Soda-Ximui/MasterTray/docs/PHASE_2_REFINEMENT.md

# Phase 2: Architectural Refinement

**Status:** Complete (implemented on refactor branch)  
**Date:** 2026-06-01  
**Version:** v4.10 (Phase 2)

---

## What's New in Phase 2

### MasterSafety.scad [NEW]

- **Purpose:** Consolidate FDM-specific safety constraints with detailed engineering rationale
- **Layer:** 1.1 (replaces inline logic from v4.0 MasterChecks)
- **Functions:** `m_safe_floor()`, `m_safe_lid()`, `m_safe_wall()`, `m_c_rad()`, `m_chamf()`, `m_wall_mod_p()`

**Why separate from MasterChecks?**

- Prepares for future split: Printer Profiles (layer heights, nozzle diameters) → separate module
- Improves readability: Each function now has 5-10 line explanation of _why_ it exists
- Enables testing: Safety constraints can be validated independently

**Example Comment:**

```scad
// === Z-AXIS SAFETY: Layer Height Alignment ===
// Floors and lids must be strict multiples of the slicer's layer height to prevent micro-stepping.
// "Micro-stepping" = slicing engine applies tiny Z-movements between layers, causing:
//   - Surface roughness on top/bottom
//   - Layer adhesion stress
//   - Warping on large flat surfaces
```

### MasterChecks.scad [UPDATED]

- **Version:** v4.0 → v4.1
- **Status:** Deprecated (now a compatibility wrapper)
- **Purpose:** Maintains backwards compatibility via delegation to MasterSafety

Existing code that includes MasterChecks continues to work without modification.

### TEST_VALIDATION_SUITE.scad [NEW]

- Comprehensive validation of all 18 part types
- Checks for syntax/runtime errors
- Confirms spec tag version = "v4.10"
- Documents expected test outcomes

---

## Architecture After Phase 2

```
Layer 3: MasterBuilder [v4.10]
   ↓
Layer 2: MasterRender [v4.9.1]
   ↓
Layer 1.5: MasterUtility [v4.8]
   ↓
Layer 1.3: MasterGridParser [NEW]
Layer 1.1.5: MasterValidation [NEW]
   ↓
Layer 1.2: MasterText [v4.0]
Layer 1.1: MasterSafety [NEW] ← Extracted from MasterChecks
Layer 1.1 (compat): MasterChecks [v4.1] (delegates to MasterSafety)
   ↓
Layer 1: MasterEngine [v4.10]
   ↓
Layer 0.5: MasterConstants [NEW]
Layer 0: MasterEnum [v4.5]
```

**Key Insight:** Layer 1.1 now explicitly separates _safety constraints_ (MasterSafety) from future _printer profiles_ module.

---

## Benefits of Phase 2 Split

| Aspect | Improvement |
| --- | --- |
| **Readability** | Safety functions now have 100+ lines of engineering context |
| **Maintainability** | Future changes to FDM limits only affect one module |
| **Testability** | Safety functions can be unit-tested independently |
| **Extensibility** | Printer profiles can now live in separate module without touching safety logic |
| **Documentation** | Every safety constraint has "why" explanation (not just "what") |

---

## Future Phase 3: Printer Profiles

When ready, extract printer-specific data into **MasterPrinterProfiles.scad**:

```scad
// Layer 1.0: Printer Profile Registry
PRINTER_PRUSA_MK3S = [
    [NOZZLE_STANDARD, 0.4],
    [LAYER_HEIGHT_STANDARD, 0.20],
    [MAX_BUILD_PLATE_WIDTH, 250],
    [OVERHANG_CRITICAL_ANGLE, 45],
];

PRINTER_CREALITY_CR10 = [
    [NOZZLE_STANDARD, 0.4],
    [LAYER_HEIGHT_STANDARD, 0.20],
    [MAX_BUILD_PLATE_WIDTH, 300],
];
```

Then MasterSafety becomes:

```scad
function m_safe_wall(data, printer_profile) =
    let(noz = get_printer_nozzle(printer_profile), loops = ...)
    max(noz * loops, ...);
```

This design keeps safety logic independent of printer choice.

---

## Backwards Compatibility Check

✅ **All existing code continues to work**

- MasterChecks v4.1 delegates to MasterSafety
- Function signatures unchanged
- No breaking API changes
- All includes still resolve

**Test:** Open MasterBuilder.scad in v4.9 → only change to MasterChecks is version number (v4.0→v4.1)

---

## Testing Checklist for Phase 2

- [x] MasterSafety.scad compiles without syntax errors
- [x] All safety functions produce identical results to v4.0
- [x] MasterChecks v4.1 delegation works (no double-calls)
- [x] TEST_VALIDATION_SUITE.scad runs all 18 part types
- [x] Spec tag shows v4.10
- [x] No render output changes vs v4.9

---

## Files Modified in Phase 2

1. **MasterSafety.scad** [NEW] – 140 lines, extensive engineering comments
2. **MasterChecks.scad** [UPDATED] – v4.0 → v4.1, now a compatibility wrapper
3. **TEST_VALIDATION_SUITE.scad** [NEW] – 80 lines, comprehensive test docs

---

## Commit Message for Phase 2

```
chore(v4.10 Phase 2): Architectural refinement - FDM safety consolidation

- Add MasterSafety.scad: Extract FDM constraints with engineering rationale
  * Detailed comments on layer height alignment, nozzle snapping, overhang limits
  * Prepares for future printer profile separation
  * Functions: m_safe_floor, m_safe_lid, m_safe_wall, m_c_rad, m_chamf, m_wall_mod_p

- Update MasterChecks.scad: v4.0 → v4.1 (now compatibility wrapper)
  * Delegates to MasterSafety.scad
  * Maintains 100% backwards compatibility
  * Deprecation notice for future removal

- Add TEST_VALIDATION_SUITE.scad: Comprehensive validation harness
  * All 18 part types documented
  * Checks syntax, runtime, spec tag version
  * Expected outputs documented

Benefits:
  ✓ Safety logic now independently testable
  ✓ Engineering rationale documented inline
  ✓ Clearer path to future printer profile module
  ✓ 100% backwards compatible

No functional changes. Render output identical to v4.9.
```

---

## Summary: Phase 1 + Phase 2

### Phase 1 (Code Clarity)

- Extracted magic numbers → MasterConstants
- Built testable grid parser → MasterGridParser
- Added validation pipeline → MasterValidation
- Modularized mesh patterns → MasterMeshPatterns

### Phase 2 (Architectural Refinement)

- Consolidated FDM safety with rationale → MasterSafety
- Created compatibility wrapper → MasterChecks v4.1
- Added validation test suite → TEST_VALIDATION_SUITE

### Result

**A parametric design system that is:**

- ✅ Production-grade and FDM-optimized
- ✅ Well-documented with engineering rationale
- ✅ Modular and independently testable
- ✅ 100% backwards compatible
- ✅ Ready for future enhancements (printer profiles, parametric snap-fits, external test suite)

---

**Ready to commit Phase 2 to refactor branch and merge both to main.**
