Soda-Ximui/MasterTray/docs/Claude Review.md

Updated todo list

Read [](file:///c%3A/repos/3D/MasterTray/MasterUtility.scad#1-101), lines 1 to 100

Read [](file:///c%3A/repos/3D/MasterTray/MasterEngine.scad)

Read [](file:///c%3A/repos/3D/MasterTray/MasterEnum.scad)

Read [](file:///c%3A/repos/3D/MasterTray/MasterUtility.scad#100-301), lines 100 to 300

Read [](file:///c%3A/repos/3D/MasterTray/MasterText.scad#1-81), lines 1 to 80

Read [](file:///c%3A/repos/3D/MasterTray/MasterChecks.scad#1-81), lines 1 to 80

Read [](file:///c%3A/repos/3D/MasterTray/MasterRender.scad)

Read [](file:///c%3A/repos/3D/MasterTray/MasterBuilder.scad)

Now let me create a comprehensive summary document:

Read [](file:///c%3A/repos/3D/MasterTray/MasterUtility.scad#100-201), lines 100 to 200

Read [](file:///c%3A/repos/3D/MasterTray/MasterChecks.scad)

Perfect! Now I have reviewed all the core SCAD files. Let me provide you with a comprehensive summary:

---

## **MASTER TRAY ECOSYSTEM: COMPREHENSIVE REVIEW**

### **Architecture Overview**
Your system uses a **4-layer modular architecture** with clean separation of concerns:

```
Layer 3: MasterBuilder.scad    (UI & Controller)
   ↓
Layer 2: MasterRender.scad     (Render Pipeline & Geometry)
   ↓
Layer 1.5: MasterUtility.scad  (Utilities & Output)
   ↓
Layer 1.1: MasterChecks.scad   (Safety & Validation)
Layer 1.2: MasterText.scad     (Text Engine)
   ↓
Layer 1: MasterEngine.scad     (Math Kernel & Data Router)
   ↓
Layer 0: MasterEnum.scad       (Lexicon & Constants)
```

---

### **FEATURES SUMMARY**

**Core Capabilities:**
1. **18+ Part Types** – Boxes, trays, lids, jars, flip boxes, pegs, grids, plaques
2. **6 Mesh Patterns** – Honeycomb, Teardrop, Slotted, Circle, Square, Diamond (+ None)
3. **Advanced Grid System** – 2D Cartesian (Nx×Ny) and Radial (R rays, C center)
4. **Snap-Fit Assembly** – C-clips, manifold bridges, hinge pins (4mm diameter)
5. **Threading System** – Built-in threaded jars with adjustable pitch
6. **Stackable Tray Variants** – Nesting, peg-based modular system
7. **Wall Modifications** – Selectable per-wall height (None/50%/25%/Dropped)
8. **Tolerance Handling** – Snap gaps (0.1mm), clip clearances, auto-tuned dimensions
9. **Metadata System** – Spec tags with version, printer settings, nozzle diameter
10. **Text/Plaque Engine** – Dynamic sizing, embossed/debossed text, copyright stamping

**Customization Depth:**
- 35+ UI parameters exposed in Customizer
- Printer settings (layer height, wall loops, nozzle diameter)
- Material simulation (floor/wall/lid thickness, divider size)
- Manufacturing tolerance adjustments

---

### **IMPLEMENTATION QUALITY**

**Strengths:**

✅ **Safety-First Design Philosophy**
- Z-axis thickness locked to layer height multiples (prevents micro-stepping)
- X/Y dimensions snapped to nozzle diameter multiples
- Wall/floor heights capped at 35% of total height (prevents brick-like solids)
- All dimensions enforce minimum physical constraints

✅ **Data-Driven Architecture**
- Unified data array format: `[[KEY, value], [KEY, value], ...]`
- Single `get_val()` function for all lookups with fallback defaults
- `process_part()` pipeline enforces safety before rendering

✅ **Intelligent Mesh Generation**
- Hole spacing auto-calculated from nozzle diameter
- Strut percentage controls gap/solid ratio independently
- Margin-aware mesh for lids (account for structural needs)
- Both rectangular and cylindrical mesh support

✅ **Advanced Geometry**
- Proper C-clip orientation (gap facing UP, eliminates overhangs)
- Manifold bridges ensure watertight assemblies
- Automatic platter layout (bin packing with row wrapping)
- 3D text rendering with kerning approximation

✅ **Version Tracking & Documentation**
- Each file has semantic version numbers
- Inline comments explain R&D decisions (v4.10, v4.11 patches)
- Spec tag injection records build parameters

**Moderate Concerns:**

⚠️ **Code Density**
- Some functions are very long single-liners (line 19, 26 in MasterRender)
- Complex ternary nesting reduces readability
- No intermediate variable names in some calculations

⚠️ **String Parsing Complexity**
- Grid layout uses custom space-separated token parsing (`"7x2"`, `"R3 C10"`)
- No formal grammar—relies on string position assumptions
- Would benefit from dedicated parser module

⚠️ **Redundant Geometry Exports**
- `render_box_grid()` and `render_internal_grid()` have overlapping logic
- Could be unified with a mode parameter

⚠️ **Limited Error Handling**
- No validation for invalid grid layouts (e.g., malformed `"7x2x2"`)
- Silent fallbacks to defaults rather than warnings

⚠️ **Hard-Coded Magic Numbers**
- Hinge diameter: `4.0` (line 115, 130, 154)
- Lip height: `8.0` (line 36, 77, 154)
- Thread chamfer: `0.5` (scattered throughout)
- Spec tag size: `120x60mm` (line 20, MasterUtility)

---

### **RECOMMENDATIONS**

#### **Priority 1: Code Clarity (High Impact)**

1. **Break apart monster functions in MasterRender**
   ```scad
   // Example: Extract framed_mesh hole generation
   module apply_pattern(pat, hole, step, nx, ny) { ... }
   module render_mesh_holes(pat, hole, step, nx, ny) { ... }
   ```

2. **Add a proper Grid Layout Parser**
   ```scad
   function parse_grid_layout(g_str) = let(tokens = str_split(g_str, " "))
       [for (tok = tokens) 
        if (search("x", tok) > 0) parse_cartesian(tok)
        else if (tok[0] == "R") parse_rays(tok)
        else if (tok[0] == "C") parse_center(tok)
       ];
   ```

3. **Extract magic numbers to constants**
   ```scad
   HINGE_DIAMETER = 4.0;
   JAR_LIP_HEIGHT = 8.0;
   SPEC_TAG_WIDTH = 120;
   SPEC_TAG_HEIGHT = 60;
   ```

#### **Priority 2: Safety & Validation (Medium Impact)**

4. **Add input validation layer**
   ```scad
   function validate_part(data) = 
       let(w = get_val(WIDTH, data), 
           h = get_val(HEIGHT, data))
       (w < 10 || h < 5) ? echo("WARN: Dimensions below minimum!") : data;
   ```

5. **Generate warnings for edge cases**
   - Wall thickness > 45% of smallest dimension
   - Grid cell size < 5mm (poor printability)
   - Text string longer than plaque can hold

#### **Priority 3: Maintainability (Medium Impact)**

6. **Document the data format**
   ```scad
   // Create a reference section in MasterEngine:
   // === DATA FORMAT SPECIFICATION ===
   // All part data: [[KEY1, val1], [KEY2, val2], ...]
   // Mandatory: [TYPE, "TYPE_NAME"]
   // Optional: Anything not found falls back to Layer 0 default
   ```

7. **Add a "Constants Audit" changelog**
   Track why each magic number exists (FDM overhang limits, snap-fit tolerances, etc.)

8. **Split MasterChecks into two files**
   - `MasterSafety.scad` (thickness capping, overhang limits)
   - `MasterPrinterProfiles.scad` (layer height, nozzle mappings)

#### **Priority 4: Feature Enhancements (Lower Priority)**

9. **Consider a "Draft Mode" for faster preview**
   ```scad
   mesh_quality = "Preview"; // ["Preview", "Final"]
   // Reduces $fn, disables fine geometry
   ```

10. **Add snap-fit geometry library**
    - C-clip can be parameterized (depth, jaw spread)
    - Reusable hinge clips for other projects

11. **Export a "Bill of Materials" function**
    ```scad
    function calc_plastic_volume(data) = ...;
    function calc_support_area(data) = ...;
    // Log during build for user reference
    ```

---

### **Code Quality Score: 7.5/10**

| Dimension | Score | Notes |
|---|---|---|
| **Architecture** | 9/10 | Excellent layering, clean dependencies |
| **Safety** | 9/10 | Comprehensive tolerance enforcement |
| **Readability** | 6/10 | Dense functions, magic numbers scattered |
| **Maintainability** | 7/10 | Good versioning, but document parsing is fragile |
| **Extensibility** | 8/10 | Easy to add new part types; geometry patterns reusable |
| **Testing** | 5/10 | No test cases; validation is implicit |

---

### **Bottom Line**

This is a **production-grade parametric design system** with excellent safety guardrails and impressive feature breadth. The 4-layer architecture keeps concerns separated, and the forced FDM compliance is sophisticated.

**Immediate action items:** Extract magic numbers, document the grid parser, and break apart the dense functions. The system will become significantly easier to maintain and extend.

Would you like me to implement any of these recommendations?
