Soda-Ximui/MasterTray/docs/START.md

# MasterTray — Where to Look

| Question | Go to |
|---|---|
| What changed and why (code quality)? | `REFACTORING.md` → commit hash |
| Something is printing wrong, is it a known bug? | `BUGS.md` |
| How does feature X work by design? | `docs/FEATURES.md` |
| What rule governs this geometry decision? | `docs/LESSONS.md` |
| What's left to do? | `TODO.md` |
| Where was I? | `HANDOFF.md` |
| What tools do I need installed? | `SETUP.md` |
