Soda-Ximui/MasterTray/MasterConstants.scad

// ==============================================================================
// FILE: MasterConstants.scad
// ARCHITECTURE: Layer 0.5 (Physical & Engineering Constants)
// PURPOSE: Centralize all magic numbers with documented rationale
// ==============================================================================

// === FDM GEOMETRY CONSTRAINTS ===
// Physical limits imposed by FDM printing mechanics and materials
HINGE_DIAMETER = 4.0; // Standard snap-fit pin diameter (PETG testbed)
HINGE_DIAMETER_FLIP = 5.5; // Flip box hinge (v4.11): Increased for better rigidity
JAR_LIP_HEIGHT = 8.0; // Threaded jar neck height (supports M8-equivalent threads)
THREAD_CHAMFER = 0.5; // Chamfer on threading to prevent slicer bridging failures
SPEC_TAG_WIDTH = 120; // Spec label plate width (accommodates 6 lines of text)
SPEC_TAG_HEIGHT = 60; // Spec label plate height (splits into 3 sections)
SPEC_TAG_DEPTH = 0.6; // Thin label thickness (mounted on printed base)

// === SNAP-FIT & ASSEMBLY ===
// Tolerances and geometry for mechanical assembly (snap, clips, hinges)
HINGE_CLEARANCE = 0.2; // Clearance around hinge pin (accounts for print tolerance ±0.1mm)
HINGE_CLEARANCE_FLIP = 0.3; // Flip box hinge clearance (v4.11): Tighter for better snap-fit
CLIP_JAW_SPREAD = 0.8; // C-clip jaw opening as % of hinge diameter (80% of axle)
CLIP_JAW_SPREAD_FLIP = 0.85; // Flip box C-clip jaw spread (v4.11): Improved gripping
CLIP_WALL_THICKNESS_MULT = 4.0; // Clip wall = nozzle_diameter × this factor
HINGE_CHAMFER_FLIP = 0.8; // Flip box hinge chamfer (v4.11): Better print quality

// === MATERIAL SAFETY ===
// Percentage caps to prevent over-thick features that waste material
MAX_FLOOR_THICKNESS_PCT = 35; // Floors capped at 35% of total height (prevent solid bases)
MAX_LID_THICKNESS_PCT = 35; // Lids capped at 35% of total height
MAX_WALL_THICKNESS_PCT = 45; // Walls capped at 45% of XY footprint (prevent thick shells)

// === MINIMUM STRUCTURAL THICKNESS ===
// [GEOM-FIX: under-thin floor/lid] m_safe_floor/m_safe_lid previously floored at ONE layer
// (m_lh) — a 1-layer floor/lid won't hold a container's contents. If the user-specified
// thickness is below these structural minimums, m_safe_* bumps it up (the slicer then fills
// the extra with perimeters/infill). Bump only RAISES sub-minimum values, so the 2.0/2.4mm
// defaults are unaffected. Minimums are clamped to the MAX_*_PCT caps so a very short/small
// part can't be over-bumped. Tunable — conservative sound minimums for typical containers.
MIN_FLOOR_MM      = 1.0;  // floor never thinner than 1.0mm ...
MIN_FLOOR_LAYERS  = 3;    // ... or 3 layers, whichever is greater
MIN_LID_MM        = 1.0;  // lid never thinner than 1.0mm ...
MIN_LID_LAYERS    = 3;    // ... or 3 layers
MIN_WALL_LOOPS    = 2;    // wall never thinner than 2 perimeters (2 × nozzle)

// === FLIP BOX STRUCTURAL IMPROVEMENTS (v4.11) ===
// Reinforcement constants for flip lid geometry fixes
// Problem: Original flip box lid warps, sags, and has snap-fit failures
// Solution: Increased hinge diameter + strategic material reinforcement
LID_HINGE_REINFORCEMENT = 2.0; // Extra thickness under hinge zone (mm)
HINGE_BOSS_DEPTH = 2.0; // Hinge boss engagement depth (mm)
HINGE_BOSS_WIDTH = 1.2; // Hinge boss width for lateral support (mm)
MANIFOLD_BRIDGE_EXTRA = 1.5; // Additional manifold bridge thickness (mm)

// === OVERHANG & BRIDGING ===
// FDM print angle and overhang limits (assumes 45° critical angle)
MAX_CHAMFER_MULT = 2.5; // Chamfer capped at nozzle_diameter × 2.5 (FDM overhang limit)

// === MESH & GRID ===
// Parameters controlling pattern generation and spacing
MIN_HOLE_SPACING = 1.2;      // Minimum gap between adjacent holes (prevents wall collapse)
HEXAGON_HEIGHT_MULT = 0.866; // sin(60°) for honeycomb grid spacing
// Minimum strut width as a fraction of hole diameter (for large holes).
// 0.25 = empirical: struts stay structurally proportional as holes grow.
// Floor = nozzle_d * 2 (2 extrusion passes minimum); this ratio only wins
// when hole > nozzle_d * 8 (e.g. > 3.2mm at 0.4mm nozzle).
STRUT_HOLE_RATIO = 0.25;

// Corner rounding for square/slotted mesh holes, as a fraction of hole size.
// 0.20 = empirical compromise: shape still reads as square, corners smooth enough
// to reduce print-head deceleration at direction changes (partial jerk relief).
// Physical floor = line_width (one extrusion width — Arachne minimum).
// Ceiling = 0.5 (fully circular — shape identity lost).
// No FDM formula derives this without knowing printer acceleration and outer-wall
// speed — treat as a tuning knob. Exposed as Corner_Round_Ratio in MasterBuilder.
RECT_HOLE_ROUND_RATIO = 0.20;

// Bambu Studio default extrusion width: 105% of nozzle diameter.
// This is the minimum printable feature width — any feature narrower triggers
// Arachne to taper the bead to near-zero, causing a pressure-control slowdown.
// Exposed as line_width global in MasterEngine.
EXTRUSION_WIDTH_MULT = 1.05;

// === PLAQUE & TEXT ===
// Text rendering and sizing for embossed features
TEXT_KERNING_MULT = 0.65; // Approximate character width as size × 0.65 (Arial Black baseline)
TEXT_PLAQUE_MIN_WIDTH = 25; // Minimum plaque backing width (prevents tiny labels)
TEXT_EMBOSS_DEPTH = 1.0; // Standard depth for embossed/debossed text

// === GRID SYSTEMS ===
// Built-in vs drop-in grid dimensions
GRID_DROP_IN_TOLERANCE = 0.4; // Clearance between grid and container (allows insertion)
GRID_BASE_HEIGHT_MULT = 4.0; // Base thickness = layer_height × 4 (2-3 shells)

// === PLATTER LAYOUT ===
// Build plate packing algorithm
PLATTER_DEFAULT_GAP = 15; // Default spacing between parts on print bed
MAX_BUILD_PLATE_WIDTH = 250; // Maximum X dimension before row wrap (Prusa MK3S+)

// === BUILD SYSTEM ===
// Metadata and version tracking
BUILDER_DEFAULT_VERSION = "v4.9.1"; // Spec tag version injection

// === PRINTER PROFILE MAPPINGS ===
// Common layer height presets (used to determine safe thickness multiples)
LAYER_HEIGHT_FAST = 0.24; // Fast & Good Enough
LAYER_HEIGHT_STANDARD = 0.20; // Standard (default)
LAYER_HEIGHT_DETAILED = 0.12; // Detailed
LAYER_HEIGHT_FINE = 0.08; // Ultra Fine

// === NOZZLE PROFILES ===
// Common nozzle diameters (drives wall/floor multiplier calculations)
NOZZLE_FINE = 0.2; // Fine detail work
NOZZLE_STANDARD = 0.4; // Standard (default)
NOZZLE_MEDIUM = 0.6; // Faster prints
NOZZLE_COARSE = 0.8; // Draft work

// === AUDIT LOG ===
// When/why constants were added or changed
// v1.0: Centralized constants previously scattered across render and safety modules
//       Rationale: Enable single-point tuning for material science experiments
//       Example: Testing different snap-fit tolerances? Just adjust HINGE_CLEARANCE
