Soda-Ximui/MasterTray/RenderLid.scad

// ==============================================================================
// FILE: RenderLid.scad
// ARCHITECTURE: Layer 3 (Factory)
// PURPOSE: All lid types — Snap, Glide (H/V, Ball/Tab), Flip_Single, Screw.
//
// All lids printed face-down (flat visible surface on bed) for best finish.
//
// LID_TYPE dispatch:
//   "Snap"        — over-cap: flat panel + short skirt slides over box exterior.
//                   Friction retention; thumb notch on box −Y wall for removal.
//   "Slide"       — matchbox: flat panel rides in open-top ±X wall grooves, slides
//                   from −Y front. Two finger holes for grip. No bridging.
//   "Glide"       — slides into grooves. GLIDE_DIR: "H" (Y-axis) | "V" (X-axis).
//                   GLIDE_SNAP: "Ball" (default, two side dimples) | "Tab" (front snap).
//   "Flip_Single" — C-clip hinge on +Y face, diamond latch on −Y face.
//   "Screw"       — internally threaded cap for jars (face-down: flat top on bed).
//   default/Slip  — plain press-fit slab, no retention.
// ==============================================================================
// BOSL2/std comes via MasterEngine — do NOT re-include (OpenSCAD has no include dedup; re-parse cost ~21s) [perf]
// MasterEngine is included once by MasterBuilder.scad (single owner) — not re-included here [perf]
include <MasterTolerance.scad>
include <RenderMesh.scad>

module factory_render_lid(data, opts, phys) {
    w  = m_bw(data); l = m_bl(data); sl = m_safe_lid(data);
    sw = phys[0][1]; noz = phys[3][1];
    lid_type  = get_val("LID_TYPE",  opts, "Slip");
    glide_dir = get_val(GLIDE_DIR,   data, "H");
    glide_snap = get_val(GLIDE_SNAP, data, "Ball");
    filament  = get_val("FILAMENT_TYPE", data, "PETG");

    echo(str("-> Factory [LID] | type=", lid_type, " glide_dir=", glide_dir, " snap=", glide_snap));

    // Ball catch shared dims (Snap + Glide Ball modes).
    // Scales with box footprint so large lids get proportionally stronger retention.
    // Capped at sw*2 so the ball never exceeds the groove wall depth.
    ball_d    = glide_ball_d(w, l, sw, noz);
    ball_r    = ball_d / 2;
    ball_protr = glide_ball_protr(ball_r, breathing_room(COMP_GLIDE, data), noz);

    if (lid_type == "Snap") {
        // Over-cap lid: flat panel + short skirt slides over box exterior.
        // No beads or ridges — completely clean flat top face.
        // Printed face-down: panel on bed (smooth), skirt walls rise upward.
        // Skirt inner cavity fits over box exterior with COMP_GLIDE clearance.
        clearance   = breathing_room(COMP_GLIDE, data);
        skirt_h     = max(noz * 8, 4.0);
        chamf       = m_chamf(data);
        lid_inner_w = w + clearance;
        lid_inner_l = l + clearance;
        lid_ow      = lid_inner_w + sw * 2;
        lid_ol      = lid_inner_l + sw * 2;
        difference() {
            union() {
                apply_master_bounds(lid_ow, lid_ol, sl, m_c_rad(data), chamf)
                    up(sl / 2) framed_mesh(data, lid_ow, lid_ol, sl, false,
                                           get_mesh_cfg(data, HOLE_LID, STRUT_LID));
                // Skirt walls fused below panel; chamfer on open mouth guides lid onto box.
                translate([0, 0, sl - EPS])
                    cuboid([lid_ow, lid_ol, skirt_h + EPS], chamfer=chamf,
                           edges=TOP, anchor=BOTTOM);
            }
            // Hollow out skirt interior (slides over box exterior).
            // EPS overlap into panel avoids coplanar bottom face.
            translate([0, 0, sl - EPS])
                cuboid([lid_inner_w, lid_inner_l, skirt_h + EPS * 2], anchor=BOTTOM);
        }

    } else if (lid_type == "Slide") {
        // Matchbox slide lid: flat panel, rails ride in open-top ±X wall grooves.
        // Printed face-down. Two finger holes for grip when pulling lid open.
        // Must match box groove formulas in RenderBox "Slide" case exactly.
        glide_tol   = breathing_room(COMP_GLIDE, data);
        rail_w      = noz * 3;
        chamf       = m_chamf(data);
        finger_d    = max(noz * 8, 6.0);
        lid_w       = w - sw * 2 + rail_w * 2 - glide_tol;
        lid_l       = l - sw - glide_tol;
        difference() {
            apply_master_bounds(lid_w, lid_l, sl, m_c_rad(data), chamf)
                up(sl / 2) framed_mesh(data, lid_w, lid_l, sl, false,
                                       get_mesh_cfg(data, HOLE_LID, STRUT_LID));
            // Two finger holes: one near front (−Y, for pulling) one near back (+Y, for pushing).
            for (sy = [-1, 1])
                translate([0, sy * lid_l / 3, -EPS])
                    cyl(d=finger_d, h=sl + EPS * 2, $fn=24, anchor=BOTTOM);
        }

    } else if (lid_type == "Glide") {
        glide_tol  = breathing_room(COMP_GLIDE, data);
        lid_style  = get_val(LID_STYLE, data, "External");

        // Lid must be at least as thick as the ball diameter so the ball is fully
        // embedded — no floating shell, no rib patch needed.
        sl_glide = max(sl, ball_d);

        // Rabbet: lid steps into inner-wall groove — slightly narrower than External.
        // External: lid rides in outer-wall groove — slightly wider than interior.
        // Must match box groove formulas in RenderBox exactly.
        rabbet_d = sw / 2;
        lid_w = (lid_style == "Rabbet")
            ? ((glide_dir == "H") ? w - sw - glide_tol      : l - sw / 2)
            : ((glide_dir == "H") ? (w - sw + 0.6) - glide_tol : l - sw / 2);
        lid_l = (lid_style == "Rabbet")
            ? ((glide_dir == "H") ? l - sw / 2      : w - sw - glide_tol)
            : ((glide_dir == "H") ? l - sw / 2      : (w - sw + 0.6) - glide_tol);

        // Rabbet: sw*3 inset keeps ball clear of the corner where backing is absent.
        // External: original 2.5-radius inset (near end, short groove).
        ball_y = (lid_style == "Rabbet") ? lid_l / 2 - sw * 3 : lid_l / 2 - ball_r * 2.5;

        union() {
            apply_master_bounds(lid_w, lid_l, sl_glide, m_c_rad(data), m_chamf(data))
                up(sl_glide / 2) framed_mesh(data, lid_w, lid_l, sl_glide, false,
                                        get_mesh_cfg(data, HOLE_LID, STRUT_LID));

            if (glide_snap == "Ball") {
                for (sx = [-1, 1])
                    // noz inset matches box socket offset — both shift inward by noz so ball
                    // and socket stay aligned. Ball still fully within lid body (ball_r ≤ sl_glide/2).
                    translate([sx * (lid_w/2 + ball_r - ball_protr - noz), ball_y, sl_glide/2])
                        sphere(d=ball_d, $fn=24);
            } else {
                tab_h = sl_glide * 0.6;
                tab_d = noz * 3;
                translate([0, -lid_l/2, tab_h/2])
                    cuboid([lid_w * 0.4, tab_d, tab_h], chamfer=tab_d/2,
                           edges=FRONT, anchor=CENTER);
            }
            // Pull tab on −Y face (trailing end when inserted): grip point to slide lid out.
            // Height spans full lid thickness; depth = noz*4 past lid face.
            // Offset to +X side (away from ball catch on ±X, away from tab catch on −Y centre)
            // so the tab is easy to identify and doesn't visually conflict with the catch.
            pull_tab_d = noz * 4;
            pull_tab_h = sl_glide * 0.7;
            pull_tab_w = 10.0;
            // Clamp so tab never runs off lid edge: half-tab + noz clearance must fit within lid_w/2.
            pull_tab_x = min(lid_w * 0.35, lid_w / 2 - pull_tab_w / 2 - noz);
            // Sunk EPS below Z=0 so bottom face doesn't share the lid face plane (non-manifold).
            // +EPS toward lid body so the +Y face overlaps lid body by EPS — breaks Y coplanarity.
            translate([pull_tab_x, -lid_l/2 - pull_tab_d/2 + EPS, -EPS])
                cuboid([pull_tab_w, pull_tab_d, pull_tab_h + EPS],
                       chamfer=pull_tab_d/2, edges=[FRONT+LEFT, FRONT+RIGHT, BOTTOM+FRONT],
                       anchor=BOTTOM);
        }

    } else if (lid_type == "Flip_Single") {
        hinge_d    = 4.0;
        clearance  = breathing_room(COMP_CCLIP, data);
        flat_belly = engagement_depth(COMP_BELLY, data);
        clasp_depth = engagement_depth(COMP_CLASP, data);
        clip_wall  = noz * 4;
        clip_outer_d = hinge_d + clearance*2 + clip_wall*2;
        // C-opening gap: PLA is brittle — wider gap means less arm flex required.
        // PETG: 80% of axle d = 0.4mm flex per arm (validated). PLA: 90% = 0.2mm flex.
        clip_gap = (filament == "PLA") ? hinge_d * 0.90 : hinge_d * 0.80;
        cc_z       = clip_outer_d / 2;
        hinge_y_off = clip_outer_d / 2;
        // lid_l: body only — C-clip adds clip_outer_d on the +Y side, so the total
        // assembly is exactly l (user's specified dimension, not l + clip_outer_d).
        lid_w = w; lid_l = l - clip_outer_d; clip_len = flip_hinge_len(lid_w, sw); clip_z = sl + cc_z;
        union() {
            // Flip lid body: minimum noz chamfer on all edges regardless of global chamfer_size=0.
            apply_master_bounds(lid_w, lid_l, sl, m_c_rad(data), max(noz, m_chamf(data)))
                up(sl / 2) framed_mesh(data, lid_w, lid_l, sl, false,
                                        get_mesh_cfg(data, HOLE_LID, STRUT_LID));
            // C-clip hinge on +Y face — suppressed if lid is too narrow for mechanism
            if (clip_len > 0) {
                // +EPS on Y: cylinder is tangent to lid body +Y face at lid_l/2.
                // Tangent contact (curved surface meets flat face at a line) can produce
                // degenerate edges in CGAL. Shifting EPS moves the tangent to lid_l/2+EPS,
                // breaking the contact — cylinder no longer touches the lid body boundary.
                translate([0, lid_l/2 + hinge_y_off + EPS, clip_z])
                    difference() {
                        union() {
                            intersection() {
                                // LINE_W so cylinder ends at ±(clip_len/2+EPS), burying the
                                // connection block face (±clip_len/2) inside the cylinder solid.
                                // h=clip_len → both at ±clip_len/2 → coplanar X faces in union().
                                yrot(90) cyl(d=clip_outer_d, h=clip_len+LINE_W, chamfer=noz*3, $fn=36);
                                cuboid([clip_len+2, clip_outer_d,
                                        clip_outer_d - flat_belly*2], anchor=CENTER);
                            }
                            // B9 fix: extend this block's overlap into the lid body (toward
                            // local -Y/-Z, which is the lid's interior — the +Y/+Z side
                            // facing the back wall is untouched, so B6's clearance is
                            // unaffected). Originally only ~1mm x 1mm of this block sat
                            // inside the lid body (a tangent-line join, not a face) — a
                            // stress riser that snapped in testing.
                            // Z: anchor the block's bottom to the print bed (local Z = -clip_z,
                            // i.e. global Z = 0) instead of a fixed ext_z offset — a fixed
                            // offset can push the bottom BELOW the bed for thin lids (sl < 1mm),
                            // which showed up as a disconnected rectangular sliver + gap at
                            // layer 1. Bed-anchoring gives the maximum possible fused area
                            // (full lid thickness) for any sl, with the top reaching 2mm past
                            // clip_z into the C-clip cylinder for fusion there.
                            ext_y = 3.0;
                            translate([0, -hinge_y_off/2 - ext_y/2, -clip_z])
                                cuboid([clip_len, hinge_y_off+2.0+ext_y, clip_z+2.0],
                                       chamfer=1.0, edges=[TOP+FRONT, TOP+BACK], anchor=BOTTOM);
                        }
                        yrot(90) cyl(d=hinge_d + clearance*2, h=clip_len+2, $fn=36);
                        // C-opening faces UP (+Z): printer traces U-shapes layer-by-layer,
                        // zero overhangs. Pin snaps in as lid rotates onto the box axle.
                        // Bridge embeds +2mm total (1mm into clip, 1mm into lid body) so
                        // the slicer sees one continuous solid — no micro-gap shell split.
                        translate([0, 0, clip_outer_d/2])
                            cuboid([clip_len+2, clip_gap, clip_outer_d + LINE_W], anchor=CENTER);
                    }
            }
            // Diamond latch arm — single solid block + diamond click tip.
            // One solid arm is structurally stronger than the old two-part split arm.
            // Bottom raised to chamf+EPS: arm ±X side faces must not intersect the lid
            //   body's front-bottom chamfer face (at Y=−lid_l/2, Z=0..chamf) — that
            //   intersection produces NM edges. Chamf+EPS clears the danger zone.
            // Root gusset (hull below): tapers from zero width at Z=0 to full arm width
            //   at Z=chamf, filling the chamfer gap without touching the chamfer face.
            //   Gives the arm a solid triangle of material from lid face to arm base.
            chamf = max(noz, m_chamf(data));
            // Root gusset: triangular fill from Z=0 (zero width) to Z=chamf (full width).
            hull() {
                translate([0, -lid_l/2 - 1.1 + EPS, EPS])
                    cuboid([EPS, 2.2, EPS], anchor=BOTTOM);
                translate([0, -lid_l/2 - 1.1 + EPS, chamf + EPS])
                    cuboid([lid_w - sw*4, 2.2, EPS], anchor=BOTTOM);
            }
            // Arm body: full depth, single solid block from chamf to arm tip.
            translate([0, -lid_l/2 - 1.1 + EPS, chamf + EPS])
                cuboid([lid_w - sw*4, 2.2, sl + clasp_depth - chamf - EPS], anchor=BOTTOM);
            // Diamond tip — the click point that engages the box wall groove.
            // Protrudes 0.9mm in +Y from arm inner face — cams into box groove on close.
            // +EPS on X: hull and arm share X width (lid_w−sw*4) → coplanar ±X faces.
            // Widening hull by EPS makes arm X faces interior to hull volume (no NM edge).
            lz = layer_snap(0.8, m_lh(data));
            translate([0, -lid_l/2 - 1.5, sl + clasp_depth])
                hull() {
                    translate([0, 0,   -lz]) cuboid([lid_w-sw*4+EPS, 0.1,   noz*1.05], anchor=CENTER);
                    translate([0, 0.9,   0]) cuboid([lid_w-sw*4+EPS, noz*2, 0.1     ], anchor=CENTER);
                    translate([0, 0,    lz]) cuboid([lid_w-sw*4+EPS, 0.1,   noz*1.05], anchor=CENTER);
                }
        }

    } else if (lid_type == "Screw") {
        // cap_h: minimum thread engagement height only.
        // BEFORE: lip_h = JAR_LIP_HEIGHT; cap_h = max(0.1, lip_h + sw * 1.5);
        //   = 8.0 + 3.6 = 11.6mm — this is the JAR NECK height, not lid height.
        //   sw*1.5 taper allowance lives on the jar body; the lid doesn't need it.
        //   Total lid was sl+11.6 = 13.6mm. See BUGS.md B2.
        // cap_h driven by Lid_Thread_Count (default 3). sw*2 floor ensures
        // at least 2 full wall passes on the cap cylinder regardless of pitch.
        cap_h   = max(m_thread_pitch(data) * get_val(LID_THREAD_COUNT, data, 3), sw * 2);
        neck_od = w - sw * 2 - 0.6;
        // Face-down: flat top on bed, interior thread on vertical walls.
        // needs_margin=false: retention is in the threaded cylinder, not the flat face.
        // Snap/Glide/Flip use needs_margin=true because their mechanisms live on the border.
        difference() {
            union() {
                up(sl / 2) framed_mesh(data, w, w, sl, true,
                                        get_mesh_cfg(data, HOLE_LID, STRUT_LID));
                // EPS sink: cylinder bottom would land at Z=sl — coplanar with lid plate top.
                up(sl - EPS) cyl(d=w, h=cap_h + EPS, chamfer2=noz*4, anchor=BOTTOM);
            }
            // EPS pullback: cutter starts one boolean-epsilon below lid surface so the
            // thread is cleanly subtracted without a zero-thickness manifold edge.
            up(sl - EPS) threaded_rod(d=neck_od + 0.8, l=cap_h+1,
                                       pitch=m_thread_pitch(data),
                                       internal=false, anchor=BOTTOM, $fn=30);
        }

    } else {
        // Slip — plain press-fit slab, no retention mechanism.
        lid_w = w - sw - 0.6; lid_l = l - sw / 2 - 0.6;
        apply_master_bounds(lid_w, lid_l, sl, m_c_rad(data), m_chamf(data))
            up(sl / 2) framed_mesh(data, lid_w, lid_l, sl, false,
                                    get_mesh_cfg(data, HOLE_LID, STRUT_LID));
    }

}
