Soda-Ximui/MasterTray/(list of files, cad)

Other CAD files:
RenderRib.scad
RenderTray.scad
deprecated/MasterBuild2.scad
deprecated/TEST_VALIDATION_SUITE.scad
