Soda-Ximui/MasterTray/build/sandbox/README.md

User-created config overrides go here (gitignored).
