Soda-Ximui/MasterTray/docs/LESSONS.md

# MasterTray — Lessons Learned

---

## 0. Structural integrity and strength are non-negotiable

**Rule:** All generated containers must have decent structural integrity. These are
functional storage objects — desiccant containers, pill organizers, general storage —
not display models. They must survive real use.

**How we achieve it:**
- **Wall thickness** = snapped to nozzle multiples via `m_safe_wall` — no partial
  extrusions, no weak inter-layer gaps
- **Floor/lid thickness** = snapped to layer-height multiples via `m_safe_floor` /
  `m_safe_lid` — flat surfaces align to layer boundaries, no micro-stepping
- **Corner bosses** on stackable trays — solid cylinder pillars at all 4 corners
  distribute stacking load into the tray walls, not just the floor
- **Strut widths** = nozzle-multiple snapped (see Lesson 0c) — every mesh strut
  is a complete extrusion pass, no weak partial lines
- **Minimum wall** = `nozzle × wall_loops` — never thinner than the slicer's
  configured perimeter count
- **Mesh strut proportion** = 25% of hole diameter minimum — large holes get
  proportionally thicker struts

**Flag immediately** if any geometry change reduces wall count below `wall_loops`,
thins a load-bearing surface below `m_safe_floor`, or introduces a mesh so open
that the remaining struts can't bear typical storage loads.

---

## 0b. All edges use chamfer or fillet — no sharp 90° overhangs

**Rule:** Every edge in the system is either chamfered or filleted. No sharp 90°
horizontal edge is left exposed on a downward-facing surface.

**Why:** FDM printers cannot print a sharp 90° overhang without supports. A chamfer
≤45° is self-supporting. A fillet on a vertical edge avoids stress concentrations
and improves layer adhesion at corners.

**How we achieve it:**

| Edge type | Treatment | Mechanism |
|---|---|---|
| Vertical corners (XY plane) | Fillet | `apply_master_bounds` → `cuboid(rounding=m_c_rad)` |
| Bottom outer edge of walls | Chamfer | `m_chamf(data)` passed to BOSL2 `cuboid`/`cyl` |
| Top of cylinder (lid, boss, peg) | Chamfer2 | `cyl(..., chamfer2=m_chamf(data))` |
| Bottom of cylinder (jar floor) | Chamfer | `cyl(..., chamfer=m_chamf(data))` |
| Peg rod ends | Chamfer both ends | `cyl(..., chamfer=0.5)` |
| Snap bead | Diamond cross-section | All faces ≤45° by geometry — no explicit chamfer needed |

**Standard values** (both physics-derived from printer settings):
- `m_chamf(data)` = `nozzle × MAX_CHAMFER_MULT` — horizontal edge chamfer
- `m_c_rad(data)` = derived from wall thickness — vertical corner fillet radius

**Flag immediately** if any new geometry introduces a horizontal edge > 45° on a
downward-facing surface, or a sharp vertical corner on an outer wall.

---

## 0c. All generated models must print support-free

**Rule:** Every primitive and composite must be printable on FDM without supports.

**How we achieve it:**
- Overhangs: `m_chamf(data)` = nozzle × 2.5 caps all chamfers at 45° max
- Mesh holes: Teardrop pattern is self-bridging (pointed tip closes without drooping)
- Lids: printed **face-down** (flat visible surface on bed) so the interior cavity
  prints upward from a solid base — no bridges, no supports
- Threads: external threads (jar body) are on vertical walls ✓; internal thread
  (lid) is subtracted from a vertical cylinder wall ✓
- Grids/dividers: vertical walls, no overhangs ✓

**Flag immediately** if any new geometry introduces: overhangs > 45°, horizontal
bridges > ~60mm, or any surface that requires the model to be printed upside-down
from the orientation it ships in.

---

## 0a. Optimal print orientation — design geometry for the print bed, not the assembly

**Rule:** All primitives ship in their optimal FDM orientation. Every factory renders
geometry as it sits on the print bed — Z=0 is the bed surface, geometry builds upward.
Users adjust slicer settings (brim, speed, enclosure temp); we never change orientation
to compensate for extreme height/width ratios.

| Primitive | Optimal orientation | Reason |
|---|---|----|
| JAR | Upright (floor on bed) | Side needs supports under curved wall; diameter becomes oval |
| TRAY / BOX | Flat (floor on bed) | Layer lines horizontal through floor = maximum strength |
| LID (Screw) | Face-down (flat top on bed) | Full-circle adhesion; interior thread on vertical walls |
| LID (Snap / Glide / Slip) | Face-down (flat outer surface on bed) | Best finish on visible face; retention features build upward |
| LID (Flip_Single / Flip_Double) | Face-down | C-clip arc at top of print — self-supporting. **Opening must face −Z (toward bed).** |
| PEG | Horizontal, flat-cut underside on bed | `yrot(90)` + flat cut prevents rolling, prints without supports |
| GRID (built-in) | Part of container — inherits container orientation | |
| GRID (drop-in) | Flat (base on bed) | Divider walls print vertically; flag very long/thin — warp risk |

**Every factory's Z=0 = bed.** If you add a new factory, the lowest point of the
geometry must sit at Z=0. Use `anchor=BOTTOM` on the outermost solid or `up(sf)` for
floor-offset geometry. A factory that floats above Z=0 will print mid-air.

**Flip lid critical rule:** C-clip arc opens **downward** (slot at `−clip_outer_d/2`).
Opening at `+clip_outer_d/2` leaves arm tips unsupported at the top of the print —
floating cantilever. See B3 in BUGS.md.

**Extreme ratios:** A 49×140mm jar prints upright regardless. A 300×200×8mm tray
prints flat regardless. Extreme geometry is a slicer concern, not an orientation concern.

**Never introduce supports** to enable a non-standard orientation. If a geometry
requires supports in its natural orientation, fix the geometry.

---

## 0b. All circle dimensions are diameters, always

**Rule:** Every circular dimension in the system (jar width, hole size, peg diameter) is
an **outer diameter** — never a radius.

**Why:** Users measure physical objects with calipers. Calipers give diameter. Asking
users to divide by 2 before typing caused real frustration. The UX loss is not worth
the cleaner internal math that radius would give.

**Consequence:** `m_bw(data)` for a jar = outer diameter. All geometry uses `d=` not
`r=` when sizing the jar cylinder.

---

Hard-won lessons from building and debugging this system. Read before touching
the include graph.

---

## 0c. Mesh hole spacing snaps to nozzle-width multiples

**Rule:** `get_grid_step` produces a step (hole + strut) that is always a whole-nozzle
multiple. Never change this to a simpler formula without understanding why.

**The formula:**
```
step = hole + max(min_sp,
                  max(noz,
                      round(max(noz*2, hole*0.25) / noz) * noz))
```

**What each layer does:**

| Layer | Expression | Purpose |
|---|---|---|
| Raw strut | `max(noz*2, hole*0.25)` | Strut is at least 2 nozzle widths wide, OR 25% of the hole diameter — whichever is larger. Large holes get proportionally thicker struts. |
| Nozzle snap | `round(.../noz) * noz` | Rounds the raw strut to the nearest nozzle-width multiple. This is the critical step — the slicer always lays complete extrusion passes. A strut of 0.6mm with a 0.4mm nozzle forces a partial pass (0.2mm leftover), which can delaminate or look ugly. Snapping to 0.8mm (2 passes) is mechanically correct. |
| Floor | `max(noz, ...)` | Guards against rounding down below 1 nozzle width. |
| Override | `max(min_sp, ...)` | Caller's physics minimum (e.g. `wall_loops × nozzle`) wins if it's larger. User-set hole spacing (`HOLE_SPACING`) flows in here. |

**Why hole*0.25?** For a 4mm hole, a 0.8mm strut (2 nozzle widths) is structurally too
thin. `hole*0.25 = 1.0mm` gives a more robust strut. For small holes (≤3.2mm with a
0.4mm nozzle), `noz*2 = 0.8mm` dominates and the minimum printable strut is used.

**The result:** Every mesh tile is a printable unit. Slicer never generates micro-moves
or partial extrusions between holes. This is the difference between a mesh that looks
right in preview and one that actually prints cleanly.

**Desiccant containers** (S4 system) lock `HOLE_SPACING=1.2mm` explicitly — this
overrides `min_sp` so airflow geometry is consistent regardless of printer wall-loop
settings.

---

## 0d. Round features must fit within their host body's Z range

**Rule:** Before placing any sphere, hemisphere, or rounded protrusion at height `h/2`
within a host body of height `h`, verify: `feature_radius ≤ h/2`.

If `feature_radius > h/2`, the feature escapes the host body:
- Below Z=0 → clips the print bed (slicer truncates it)
- Above Z=h → pokes past the top face with no wall support at those layers

The top portion prints as a **floating shell** that detaches mid-print. The slicer
may not warn — it only warns if the feature has *no* connection at all. A feature
that starts connected but loses its wall attachment partway up passes slicer checks
and fails in print.

**Two confirmed failures (see BUGS.md B3, B4):**
1. C-clip hinge arm tips — arc opening at +Z left tips floating above lid top
2. Glide ball catch — sphere at sl/2 with ball_r > sl/2 → top of ball floats above lid

**Preferred fix: thicken the host body.**

If a round feature doesn't fit within the host's Z range, increase the host
thickness so it does. This is cleaner than adding ribs or repositioning geometry.

```scad
// Glide lid — ensure ball is fully embedded
sl_glide = max(sl, ball_d);   // lid at least as thick as ball diameter
// Ball center at sl_glide/2 — ball_r ≤ sl_glide/2, always within body
translate([sx * (wall_edge + ball_r - ball_protr), y, sl_glide/2])
    sphere(d=ball_d);

// Plaque socket — ensure face plate is at least as thick as socket OD
p_t_eff = max(p_t, od);       // slab fully backs the socket base, no bridging
```

**Fallback fix: full-height connecting rib.** When thickening would break mating
geometry or is too expensive dimensionally, add a rib that spans the full host
height and connects the feature to the host wall at every layer:

```scad
// Rib inset inside wall, no protrusion into groove channel
translate([sx * (wall_edge - ball_r/2), y, sl/2])
    cuboid([ball_r + EPS, ball_d * 0.7, sl + EPS], anchor=CENTER);
```

| Situation | Preferred fix | Fallback |
|---|---|---|
| Ball catch on thin slab | `sl = max(sl, ball_d)` | Full-height rib inset inside wall |
| Socket OD > slab thickness | `p_t = max(p_t, od)` | Rib / boss at socket base |
| Arc/C-shape printed face-down | Opening at −Z (arc self-supporting) | — |

**Flag immediately** any sphere, hemisphere, or cylindrical snap feature placed at the
midpoint of a thin slab without verifying the Z-range containment condition.

---

## 1. Factory IS the implementation — opts drive all variants

**Rule:** Each primitive shape has exactly ONE factory function. All behavioural
variants are driven by opts, not by separate factory functions or wrapper chains.

**Why:** Multiple render_*() wrappers around a single chassis create layered
indirection. Every new derived intent requires fighting through all layers to inject
behaviour — contorted, fragile, and hard to reason about.

**The pattern:**
```
factory_render_box(data, opts, phys) {
    lid_type = get_val("LID_TYPE", opts, "Snap");
    if      (lid_type == "Glide")        { ... groove + ball dimples inline ... }
    else if (lid_type == "Flip_Single")  { ... hinge boss + axle inline ... }
    else if (lid_type == "Flip_Double")  { ... dual hinge inline ... }
    else                                 { ... plain chassis ... }
}
```

**What this eliminates:**
- render_box() / render_flip_box() / render_double_flip_box() wrapper chain
- NEEDS_GROOVE flag smuggled through data to cross layer boundaries
- Separate factory_render_flip_box() that does nothing but call the real thing
- Adding a new variant = add one `else if` branch in ONE file

**Corollary:** The manifest is the only place that decides WHAT to build.
The factory is the only place that decides HOW to build it.
Never let behaviour bleed from manifest into data (via data overrides) just to
cross a factory boundary.

---

## 2. Built-in grid height is driven by LID_TYPE — the tray adapts to its lid

**Rule:** When a tray/box has a built-in grid (`HAS_BUILTIN_GRID=true`), the internal
divider wall height is NOT simply "tray height minus floor". It is capped by whatever
the lid type requires to close properly.

**The constraint per lid type:**

| LID_TYPE | Grid wall height cap | Reason |
|---|---|---|
| Plain / Snap / Glide | `bh - sf - sl` | Full interior height |
| `Flip_Single` | `axle_z` = `bh - clip_outer_d/2` | Lid must flip closed over dividers |
| `Flip_Double` | `axle_z` (same) | Same hinge geometry |

**How it flows:**
```
factory_render_box(data, opts, phys)
  lid_type = get_val("LID_TYPE", opts)
  grid_wall_h = lid_type == "Flip_*" ? axle_z : bh - sf - sl
  d = concat([[GRID_WALL_H, grid_wall_h]], data)  ← inject before chassis call
  core_tray_chassis(d)
    → render_internal_grid(d)
        → reads GRID_WALL_H from d
        → dividers capped at grid_wall_h
```

**The hinge pillars ARE the grid divider pillars** (on the hinge side). In
`factory_render_box` with `Flip_Single`, the inter-column divider stubs at the +Y
face serve both as structural hinge support AND as grid column separators. They
are built by `factory_render_box`, NOT by `render_internal_grid`. The internal
grid handles only the full-depth dividers running front-to-back.

**Implementation note:** `GRID_WALL_H` must be in MasterEnum and prepended to
data in the factory before calling `core_tray_chassis`. `render_internal_grid`
reads it with `get_val(GRID_WALL_H, data, bh - sf - sl)` — the fallback is the
full interior height for plain boxes.

---

## 3. `use` vs `include` for factory modules

**Rule:** Use `include` for your own factory files. Use `use` only for
third-party libraries (BOSL2).

**Why:** OpenSCAD's `use <file>` is supposed to import module and function
definitions without executing top-level code. In practice, when the used file
has nested `include` chains with complex dependencies, `use` silently fails to
register module definitions — producing "WARNING: Ignoring unknown module 'X'"
with no other explanation.

**What happened:** MasterBuilder used `use <RenderJar.scad>`. RenderJar
includes RenderMesh which includes MasterMeshPatterns and MasterEngine.
Through this chain, `factory_render_jar` was never registered in MasterBuilder's
scope. The fix was changing to `include <RenderJar.scad>`.

**Safe because:** None of the factory files (RenderJar, RenderTray, RenderLid,
etc.) contain top-level executable geometry — they are pure module definitions.
`include` on a file with no top-level execution is identical in effect to `use`,
except it reliably brings module names into scope.

**Rule of thumb:**
```
include <your_own_factory.scad>   // always safe, always works
use     <BOSL2/std.scad>          // correct for third-party libraries
```

---

## 2. `return` is not valid at the top level of an OpenSCAD file

**Rule:** Never use `return` outside a function body in OpenSCAD.

**Why:** `return` is only valid as the implicit last expression inside a
function definition. At the top level of a file, OpenSCAD may parse it as a
call to an unknown module named "return", which silently aborts processing of
the rest of the file — including all module definitions below that line.

**What happened:** RenderMesh.scad had a double-inclusion guard:
```scad
if (!is_undef(MESH_LOADED)) return;
MESH_LOADED = true;
```
When this file was included, the `return` call aborted processing of the rest
of the file. Any file that included RenderMesh.scad and defined modules *after*
that include had those modules silently dropped.

**Fix:** Remove top-level `return` guards entirely. OpenSCAD handles
double-inclusion naturally — variables and modules defined multiple times just
take the last value, and the overhead is negligible.

---

## 3. Hardcoded physics values in the manifest are wrong

**Rule:** Always compute physics from data. Never hardcode them.

**Why:** The manifest stub originally hardcoded safety values:
```scad
[["SAFE_WALL", 2.4], ["SAFE_FLOOR", 2.0]]
```
These are the defaults for a 0.4mm nozzle with specific settings. A user with
a 0.6mm nozzle, different wall loops, or a thick floor setting would silently
get wrong geometry — walls that don't match their slicer, floors that don't
align to their layer height.

**Fix:** Always call `get_physics_profile(data)` which computes safe values
from the actual user payload:
```scad
get_physics_profile(data)  // derives from nozzle, layer height, wall loops
```

---

## 4. File-level version numbers create false confidence

**Rule:** Don't version individual files — use git.

**Why:** File headers like `[v4.13]` diverge from reality the moment a file
is edited without updating the number. They also create confusion when two
files claim the same version for different states of the code.

**Fix:** Remove all `[vX.Y]` tags from file headers. `git log -- filename`
shows the real history with actual context. The header should describe
*purpose*, not version.

---

## 5. Duplicate function definitions cause silent wrong-output bugs

**Rule:** Every function lives in exactly one file.

**Why:** OpenSCAD silently uses whichever definition it sees last (determined
by include order). If two files define `get_mesh_cfg` with different signatures,
callers get unpredictable behavior depending on which file was included first —
no error, no warning, just wrong geometry.

**What happened:** `get_mesh_cfg` existed in both `MasterEngine.scad` (correct
version with `needs_margin` guard) and `MasterLegacyBridge.scad` (simplified
version with `is_lid` parameter that ignored NONE patterns). Callers passing
`true` to apply lid minimum-solid logic were silently getting wrong mesh configs.

**Fix:** Delete the duplicate. Keep the canonical version in MasterEngine.

---

## 6. `include` inside a `use`d file may not propagate module definitions upward

**Rule:** If module A is defined in file X, and file Y does `include <X>`,
then `use <Y>` from file Z may or may not make module A visible in Z's scope.

**Why:** OpenSCAD's `use` processes the direct file for definitions. Modules
from transitively `include`d files may not be promoted into the calling scope.

**Consequence:** Even if `factory_render_jar` is defined in RenderJar.scad and
RenderJar.scad is `use`d by MasterBuilder.scad, the module might not be visible.
The only reliable solution is `include`.

---

## 7. Ternary `? :` cannot select between module calls in OpenSCAD

**Rule:** Use `if/else` to choose between modules. Use `? :` only for value
expressions inside functions or variable assignments.

**Why:** In OpenSCAD, `? :` is an expression operator — it returns a value.
Module instantiations (`circle()`, `rect()`, `cyl()`) are statements, not
values. Using ternary to choose between module calls is a syntax error:

```scad
// WRONG — syntax error
linear_extrude(h) is_cyl ? circle(d=w) : rect([w, l]);

// CORRECT
linear_extrude(h) {
    if (is_cyl) circle(d=w);
    else        rect([w, l]);
}
```

**What happened:** `framed_mesh` in RenderMesh.scad used ternary to select
between `circle()` and `rect()` children of `linear_extrude`. This was masked
by the MESH_LOADED guard (lesson 2) which prevented the file from ever loading.
Removing the guard exposed the underlying syntax error.

---

## 8. Enum values must be human-readable to work with the Customizer

**Rule:** Enum constant names follow code convention (ALL_CAPS). Enum string
values must match the Customizer dropdown labels exactly (human-readable,
mixed-case).

**Why:** The OpenSCAD Customizer reads the dropdown options from inline
comments and sets the variable to that exact string:

```scad
mesh_pattern = "Teardrop"; // ["Honeycomb", "Teardrop", "Slotted"...]
//                                           ↑ this exact string becomes the value
```

So enum values must be the same human-readable strings the Customizer shows.

**The pattern that works for both worlds:**
```scad
// MasterEnum.scad — constant name is ALL_CAPS, value is human-readable
TEARDROP = "Teardrop";
HONEYCOMB = "Honeycomb";

// MasterBuilder.scad Customizer dropdown — values match enum strings
mesh_pattern = "Teardrop"; // ["Honeycomb", "Teardrop", ...]

// Dispatcher — use the constant, not a raw string
if (pat == TEARDROP) ...   // "Teardrop" == "Teardrop" ✓
```

Using the constant everywhere means a label change only needs fixing in
MasterEnum — it propagates automatically. Raw strings scattered through
dispatchers (`"TEARDROP"`) break silently when the enum value differs.

**What happened:** `MasterMeshPatterns.scad` dispatched on `"HONEYCOMB"`,
`"TEARDROP"` (all-caps raw strings). The enums and Customizer both used
`"Honeycomb"`, `"Teardrop"` (mixed-case). Every pattern check silently
fell through — no mesh holes were ever cut, no warning issued.

**Fix:** Use the enum constants in all dispatchers. Never use raw strings
in comparisons.

---

## 9. Boolean Epsilon (`EPS` / `LINE_W`) — what it is and when to change it

> **Naming note (2026-06-17):** the variable formerly called `EPS2` is now `LINE_W`.
> It is **`= Nozzle_Diameter`** (one extrusion line width, ~0.4mm at default), used as
> double-sided cutter overlap (~`LINE_W/2` per face). Older text below that frames it as
> "`EPS * 2`" describes the *general* "extend both ends" principle, not this variable's
> value — `LINE_W` is a full line width, not `2 × EPS`. When in doubt, `LINE_W = Nozzle_Diameter`.

### What the problem is

When a `difference()` cutter's face sits exactly flush with the face it is supposed to
pierce, OpenSCAD cannot determine which side of the boundary each floating-point point
belongs to. The result is:

- **F5 preview** — the face flickers or shimmers (Z-fighting). The renderer oscillates
  between "inside" and "outside" on each redraw.
- **F6 render / STL export** — the coincident face may produce a non-manifold edge.
  Some slicers (Bambu Studio, PrusaSlicer) will warn "model has holes" or silently
  mis-slice the affected region.

### The fix

Extend every cutter slightly past the face it needs to pierce.

```
Without EPS:                   With EPS = 0.1:
┌──────────┐                   ┌──────────┐
│  solid   │                   │  solid   │
├──────────┤  ← ambiguous      │          │
│  cutter  │                   ├──────────┤ 0.1mm past face
└──────────┘                   │  cutter  │
                                └──────────┘
```

`EPS = 0.1` extends one end of a cutter by 0.1mm.  
`LINE_W = EPS * 2` extends both ends — used when a cutter must pierce through completely
(e.g., a socket hole that starts above the solid and exits below).

### Effect on printed geometry

`EPS` is a **display and export artifact only**. The 0.1mm overlap on a socket cutter
makes the hole 0.1mm deeper than the nominal dimension. At FDM tolerances (±0.1–0.2mm)
this is invisible. The rule is:

> If the cutter is subtracted from a face, add `EPS` on that end.  
> If it must pierce both faces, use `LINE_W` total (split as `up(-EPS)` + `h + LINE_W`).

### When to change the slider

| Symptom | Action |
|---|---|
| Flickering face in F5 preview | Raise to 0.02–0.05 |
| Slicer reports non-manifold on a flat cut surface | Raise to 0.05 |
| No symptoms | Leave at 0.01 — verified clean across all part types |

**Never set below 0.005.** Below that, floating-point trig error in arc vertex positions
can match the EPS value and the separation disappears inside CGAL.

**0.1 is the practical ceiling.** Above that, the cutter overlap starts to measurably
shift interior face positions, which matters for tight-fit features like snap beads and
hinge sockets.

### Where it is used in code

Every `difference()` cutter that cuts a face at a shared boundary uses `EPS` or `LINE_W`.
Defined in `MasterEngine.scad`; overridden by `bool_overlap_eps` from the Customizer
(the MasterBuilder assignment runs after all includes, so it wins).

Files that consume `EPS` / `LINE_W`:

| File | Use |
|---|-----|
| `RenderGrid.scad` | Hollow span cutter; radial spoke-to-hub fusion overlap |
| `RenderTray.scad` | Nesting ledge, peg socket cutters, corner boss fusion nudge |
| `RenderBox.scad` | Glide groove cutter length |

---

## 10. How to override user input and set flags from the manifest

### How data lookup works

`get_val(KEY, data, default)` scans `data` linearly and returns the **first** value
whose key matches. The user's Customizer payload is the tail of the array. Prepend
to win:

```scad
// User set GRID_LAYOUT = "2x3" in the Customizer.
// Manifest injects a different value:
d = concat([[GRID_LAYOUT, "7x1"]], data);
// get_val(GRID_LAYOUT, d, "") → "7x1"  ← manifest wins
```

### Overriding one key

```scad
(intent == "7-Day Pill Box") ?
    let(d = concat([[GRID_LAYOUT, "7x1"]], data))
    [["BOX", d, [["LID_TYPE", "Flip_Single"]], get_physics_profile(data)], ...]
```

### Overriding multiple keys

```scad
let(d = concat([[GRID_LAYOUT, "7x1"], [HAS_BUILTIN_GRID, true]], data))
```

Order within the prepended block does not matter — they are all before any user key.

### Named override block (S4 pattern)

When many keys need overriding, build the block separately for readability:

```scad
let(d = concat([["WIDTH", 49], ["LENGTH", 49], ["HEIGHT", 140]], DESICCANT_MESH_CYL, data))
```

`DESICCANT_MESH_CYL` is itself an array of `[KEY, val]` pairs — `concat` flattens
one level, so this works cleanly.

---

### `data` vs `opts` — what goes where

| Channel | What it carries | Read by |
|---|---|---|
| `data`  | Geometry, physics, grid config, flags that affect the *container* shape | `factory_render_*`, `core_tray_chassis`, `render_internal_grid` |
| `opts`  | Per-component dispatch flags that affect *which variant* is built | The factory's first `let` block — e.g. `lid_type = get_val("LID_TYPE", opts, "Snap")` |

If a flag controls **how a container is shaped** (grid layout, built-in grid, thread neck, desiccant mesh) → put it in `data`.  
If a flag controls **which factory branch to take** (lid type, thread on/off, jar grid mode) → put it in `opts`.

---

### Common flags

| Flag | Where | Effect |
|---|---|---|
| `HAS_BUILTIN_GRID` | `data` | Activates `render_internal_grid` inside the chassis. Must also set `GRID_LAYOUT`. |
| `GRID_LAYOUT` | `data` | Layout string parsed by `GridLayout.scad`. Format: `"NxM"` cartesian, `"RN"` radial rays, `"SR/C/RS/CS"` span, combinable with spaces. |
| `GRID_WALL_H` | `data` | Max divider height (injected by `factory_render_box` — do not set from manifest). |
| `IS_JAR_GRID` | `opts` | Tells `factory_render_grid` to clip cartesian walls to the jar's circular boundary. Set this on standalone `GRID` parts for jar contexts. |
| `IS_THREADED` | `opts` | Adds threaded neck to a JAR. |
| `SKIP_PILLARS` | `data` | Suppresses flip-box hinge pillars (used for single-lid multi-compartment boxes where the lid spans the full width). |
| `GRID_HAS_BASE` | `data` | Adds a solid floor layer to a drop-in grid. Defaults `false` — opt-in only. |
| `DESICCANT_MESH_RECT` / `DESICCANT_MESH_CYL` | prepended to `data` | Forces teardrop mesh with airflow-optimized hole/strut geometry. Overrides all user mesh settings. |

---

### Grid layout string reference

```
"3x4"              → 3 columns, 4 rows (cartesian)
"R6"               → 6 radial dividers from centre (jar only)
"C20%"             → radial core radius = 20% of jar radius (default 6mm absolute)
"S2/3/2/2"        → span at row 2, col 3, spanning 2 rows × 2 cols, full height
"S2/3/2/2/60%"    → same span, height capped at 60% of interior height
"3x4 R6 C20%"     → cartesian + radial combined
"3x4 S2/3/2/2 R6" → cartesian + span + radial
```

Tokens are space-separated and order-independent. `parse_cartesian`, `parse_radial`,
and `parse_spans` each scan the full token list independently.

---

## 7. Slicer-aware geometry — Arachne speed optimization

These rules eliminate two distinct slicer slowdown mechanisms that cause visible print
artifacts and wasted print time. Both are fixed by tying geometry thresholds to
`nozzle_d` (available everywhere via `MasterEngine.scad`).

**Extrusion width** = `nozzle_d * 1.05` — Bambu Studio's default line width at 105% of
nozzle diameter. This is the minimum printable feature size. Any geometry smaller than
this forces the slicer into a slow-path.

---

### 7a. Arachne pressure pinch — tip truncation

**What it is:** Arachne (variable-width extrusion engine) must taper the bead to match
the geometry. When a tip comes to a point narrower than the extrusion width, Arachne
slows the head to near-zero to control pressure. Result: blobs, surface marks, wasted time.

**Rule:** No printed geometry tip narrower than `nozzle_d * 1.05`.

**Applied in this codebase:**

| Geometry | File | Fix |
|---|---|-----|
| Teardrop mesh hole | `MasterMeshPatterns.scad` | Triangle tip → trapezoid flat top of `nozzle_d * 1.05` width |
| Diamond mesh hole | `MasterMeshPatterns.scad` | Pointed rhombus → vertical tips truncated to `nozzle_d * 1.05` |
| Flip latch tab | `RenderLid.scad` | Hull Z-tips: `0.1mm` → `noz*1.05` |
| Flip latch recess | `RenderBox.scad` | Cutter mirrors tab shape — same fix |

**Teardrop geometry note:** The roof must also be exactly 45° from horizontal (the FDM
critical overhang angle for PETG). The roof polygon starts at the 45° points on the
circle — `[r·cos45, r·sin45]` — not from the base diameter. Starting from the base
produces ~56° sides that need support.

```scad
// Correct: 45° roof + flat top
bx = r * cos(45);  by = r * sin(45);  th = r + by;  w = nozzle_d * 1.05;
polygon([[-bx, by], [bx, by], [w/2, th], [-w/2, th]]);
```

---

### 7b. Motion planner jerk — corner rounding

**What it is:** A sharp 90° corner forces the print head to dead-stop on one axis before
accelerating on the other. The motion planner's jerk limit kicks in, causing a pressure
spike that leaves a corner blob and wastes time.

**Rule:** Round all sharp 90° corners on mesh holes to `rounding = nozzle_d`.

**Applied in this codebase:**

| Geometry | File | Fix |
|---|---|-----|
| Square mesh holes | `MasterMeshPatterns.scad` | `rect([hole, hole], rounding=nozzle_d)` |
| Diamond mesh holes | `MasterMeshPatterns.scad` | Side corners covered by truncated rhombus polygon |
| Slotted mesh holes | `MasterMeshPatterns.scad` | `rounding=max(hole*0.2, nozzle_d*1.05)` |

**Note:** Honeycomb (`$fn=6`) is intentionally left un-rounded. The straight hex sides
bridge cleanly as long as struts are wide enough. Rounding would distort the shape.

---

### 7c. Circle quality — `$fs` / `$fa` over `$fn`

**Rule:** Never use a global `$fn` for print quality. Use `$fs` (max chord length) and
`$fa` (max angle) so each circle auto-computes the right facet count for its diameter.

```scad
$fn = $preview ? 24 : 0;        // 0 = let $fs/$fa control
$fs = $preview ? 2  : nozzle_d; // chord ≤ nozzle diameter
$fa = $preview ? 10 : 1;        // secondary angle guard
```

A global `$fn=128` is too coarse for circles > ~16mm diameter (visible faceting) and
wasteful for small circles. `$fs = nozzle_d` scales correctly for every circle size.

**Hard-coded `$fn` overrides are intentional and win over `$fs`:**
- `$fn=6` → hexagon mesh holes (not a smooth circle)
- `$fn=30` → threaded neck (thread pitch geometry)
- `$fn=36` → hinge/clip cylinders (mechanical fit tolerance)

---

### 7d. What NOT to change

The `0.6mm` offsets in Glide lid and Screw lid geometry are **mechanical clearance
tolerances** — intentional fit values, not print-quality thresholds. Do not replace
these with nozzle-parametric expressions.

---

## 11. Non-manifold edges — detection and avoidance

### What causes non-manifold edges

A mesh is non-manifold when two faces share more than one edge, or when faces share an
edge with zero volume between them (coplanar coincident faces). OpenSCAD's CGAL kernel
silently produces these in three situations:

| Situation | Example |
|---|---|
| `union()` addition's face is **exactly coplanar** with the chassis outer wall | Pillar outer X-face at exactly ±w/2 |
| `union()` addition's face is **exactly coplanar** with another addition's face | Pull tab +Y at lid body -Y |
| `difference()` cutter's face is **exactly flush** with the face it pierces (Z-fighting) | Groove cutter base at groove_z without EPS |

Slicers (Bambu Studio, PrusaSlicer) warn "model has non-manifold edges" and attempt
auto-repair. Repair sometimes creates floating islands that print as disconnected blobs.

### The EPS rule

**Any face added in `union()` that would land exactly on a chassis boundary must be
nudged by `EPS` past that boundary so the solids genuinely interpenetrate.**

```
BAD:  pillar outer face at w/2  ← coplanar with box outer wall → non-manifold
GOOD: pillar width sw*3 - EPS  ← outer face at w/2 - EPS/2 → no shared plane
```

```
BAD:  pull tab +Y face at -lid_l/2  ← coplanar with lid body -Y face → non-manifold
GOOD: translate Y += EPS            ← +Y face at -lid_l/2 + EPS → overlaps into body ✓
```

**Critical direction rule:** The EPS nudge must make the added solid's face land INSIDE
the chassis material — not past it. A face nudged past the chassis creates a new
coplanar junction at the chassis outer surface.

```
WRONG: pillar depth = clip_od + EPS → back face at l/2 + EPS (past outer wall)
       Box wall outer face at l/2 is now flush with the pillar's base face → new non-manifold
CORRECT: pillar depth = clip_od - EPS → back face at l/2 - EPS (inside wall material)
```

For difference() cutters the mirror rule applies — extend the cutter by EPS past every
face it must pierce (Lesson 9 details this).

### How to audit a new feature for coplanar faces

For every solid added in `union()`, compute the extreme face coordinates and compare
against the chassis outer wall coordinates:

| Check | Outer wall at | Compare against |
|---|---|---|
| Left X face | `-w/2` | `center_x - width/2` |
| Right X face | `+w/2` | `center_x + width/2` |
| Front Y face | `-l/2` | `center_y - depth/2` |
| Back Y face | `+l/2` | `center_y + depth/2` |
| Bottom Z face | `sf` (floor top) | `translate_z + 0` |
| Top Z face | `h` | `translate_z + height` |

If any computed face coordinate equals the chassis wall coordinate exactly → add/subtract
`EPS` on that dimension.

**High-risk patterns** — always audit these:
- Pillar/boss next to an outer wall (X or Y face may align with wall)
- Feature at Z=0 added to a lid (`union()` at the flat face plane)
- Feature at Z=sf (floor top) added to a box interior
- Any `anchor=BOTTOM+FRONT/BACK/LEFT/RIGHT` cuboid placed with translate touching a wall

### Confirmed instances in this codebase

| Feature | File | Coplanar face | Fix |
|---|---|---|-----|
| Flip_Single hinge pillars | `RenderBox.scad` | Left/right outer X at ±w/2; back Y at l/2; bottom at Z=sf | `sw*3-EPS` width, `clip_od-EPS` depth, `sf-EPS` Z, height`+EPS` |
| Flip_Double spine pillars | `RenderBox.scad` | Left/right outer X at ±w/2; bottom at Z=sf | `sw*3-EPS` width, `sf-EPS` Z, height`+EPS` |
| Flip_Single/Double diamond latch hull (box) | `RenderBox.scad` | Hull root face at outer wall Y face (±l/2) | `translate([0, ±(l/2-EPS), latch_z])` (see §11j) |
| Glide lid pull tab | `RenderLid.scad` | +Y face at -lid_l/2 (lid body -Y) | translate Y += EPS |
| Latch arm on Flip lid | `RenderLid.scad` | Bottom face at Z=0 (lid flat face) | translate Z -= EPS |
| Thumb notch in box end wall | `RenderBox.scad` | Top face at groove_z (groove cutter bottom) | translate Z += EPS |
| Snap lid retention bead (both styles) | `RenderLid.scad` | Degenerate EPS-thin flat face (chamfer = height/2) | `chamfer = (height - m_lh) / 2` (see §11c) |
| Flip_Double spine pillar ±Y faces | `RenderBox.scad` | Pillar ±Y faces exactly tangent to axle cylinders (pillar face = cylinder tangent point) | `spine_w = hinge_y*2 + hinge_d + EPS*2` (see §11f) |
| Flip_Single lid C-opening cutter | `RenderLid.scad` | Cutter top coplanar with connection-block top at local z=0 | `clip_outer_d + LINE_W` on cutter height (see §11d) |
| Flip_Single lid diamond tip hull | `RenderLid.scad` | Hull cuboid X face coplanar with latch arm X face | Hull width `lid_w-sw*4+EPS` (see §11e) |
| Flip_Single/Double axle pins | `RenderBox.scad` | Pin end cap at ±(w/2−sw) = inner wall X face | `h=w−sw*2+LINE_W` (see §11h) |
| Flip_Single lid C-clip foot | `RenderLid.scad` | Connection block X = cylinder X = ±clip_len/2, coplanar in inner `union()` | Block width `clip_len−EPS` (see §11i) |
| Flip_Single lid latch arm root | `RenderLid.scad` | Arm ±X side faces passing through lid body front-bottom chamfer zone (Z=0 to chamf) | Raise arm bottom to `chamf+EPS`, reduce height by `chamf+EPS` to keep top fixed (see §11k) |

### Floating regions after non-manifold repair

When a slicer auto-repairs non-manifold edges by capping the zero-thickness gap, it can
create a paper-thin disconnected face that prints as a floating island. Symptom: slicer
preview shows a small translucent blob separate from the main model. Root cause is always
a coplanar union face — the fix is always the EPS nudge above, not a slicer setting.

### Cantilever vs floating region — not the same

A **cantilever** is a feature that overhangs with no support below it in the print
orientation. This is a printability concern — addressed by chamfers and print orientation.

A **floating region** is a disconnected volume in the mesh — the slicer sees it as a
separate body with no connection to the main model. This is a geometry error — addressed
by EPS overlaps.

Lids print face-down (Z=0 on bed). The pull tab and latch arm both start at Z=0,
attached to the bed via the lid body. They are vertical walls building upward — not
cantilevers. If the slicer flagged them as floating regions, the root cause was the
coplanar face (non-manifold), not the overhang geometry.

---

### 11a. Mathematical detection — catch coplanar faces before running OpenSCAD

For any cuboid added in `union()`, the six face coordinates are pure arithmetic.
Compare each against the chassis boundary coordinates. If any match exactly → non-manifold.

**Step 1 — write down the chassis boundaries:**
```
left   X = -w/2          right  X = +w/2
front  Y = -l/2          back   Y = +l/2
bottom Z = 0 (or sf)     top    Z = h
```

**Step 2 — compute face coordinates of the added solid:**

For `translate([cx, cy, cz]) cuboid([dx, dy, dz], anchor=BOTTOM)`:
```
left   = cx - dx/2        right  = cx + dx/2
front  = cy - dy/2        back   = cy + dy/2
bottom = cz               top    = cz + dz
```

For `anchor=BOTTOM+FRONT` (BOSL2: FRONT = −Y, BOTTOM = −Z):
```
left   = cx - dx/2        right  = cx + dx/2
front  = cy               back   = cy + dy    ← FRONT face is at the translate Y
bottom = cz               top    = cz + dz
```

**Step 3 — flag any match:**

| Flip_Single left pillar | Math | Chassis | Match? |
|---|---|---|---|
| left X | `-(w-sw*2)/2 + sw/2 - (sw*3)/2` = `-w/2` | `-w/2` | ✗ COPLANAR |
| back Y | `(l/2 - clip_od) + clip_od` = `l/2` | `+l/2` | ✗ COPLANAR |

No code needed — just algebra with the translate and dimension expressions.

**Rule of thumb:** if a dimension expression can be simplified to `±w/2`, `±l/2`, `0`, or `h`,
it is coplanar with a chassis face and needs an EPS adjustment.

---

### 11b. Why you can't just "EPS everywhere"

The instinct is right but direction matters. EPS must push the face **into** the chassis
(overlap = valid union), never **past** it (protrusion = new coplanar face on the other side).

```
Scenario: pillar back Y face must not land at l/2.

Option A — make depth larger (clip_od + EPS):
  back face = l/2 + EPS  ← protrudes past outer wall
  New problem: the tiny EPS sliver has its BASE face at l/2 = outer wall face → NEW coplanar ✗

Option B — make depth smaller (clip_od - EPS):
  back face = l/2 - EPS  ← stays inside wall material
  The outer wall at l/2 is uninterrupted. Union is clean. ✓
```

**The blanket rule that always works:**

> When sizing geometry to fill a space up to a wall, make it `- EPS` on that dimension.
> When positioning geometry to touch a face, offset the translate by `EPS` toward the interior.

A one-liner way to remember: **shrink inward, never grow outward.**

"EPS everywhere" works if you apply it consistently in the inward direction. The problem
is that "inward" is different for each face:

| Face | Safe direction | Expression |
|---|---|---|
| Touches left wall (−X) | push right | `width - EPS` (shrink) |
| Touches right wall (+X) | push left | `width - EPS` (shrink) |
| Touches back wall (+Y) | pull forward | `depth - EPS` (shrink) |
| Touches front wall (−Y) | pull back | `depth - EPS` (shrink) |
| Touches bottom face (Z=0) | push up | `translate_z - EPS` (sink translate) |
| Touches top face (Z=h) | push down | `height - EPS` (shrink) or `translate_z - EPS` |

The `difference()` cutter direction is the **opposite**: extend the cutter **past** the face
(cutter must pierce through, not stop flush). That's `+ EPS` on cutters, `- EPS` on additions.

Summary table — two rules, cover everything:

| Operation | Face must pierce | Face must stop flush | Rule |
|---|---|---|---|
| `difference()` cutter | yes | — | `+ EPS` (extend past) |
| `union()` addition | — | yes | `- EPS` (shrink inward) |

---

### 11c. Degenerate flat face — `chamfer = height / 2`

A BOSL2 `cuboid` with `chamfer = h/2` on both `TOP` and `BOTTOM` edges leaves exactly
zero flat face: the two 45° chamfer planes meet at the midpoint and the remaining flat
section has zero height. CGAL sees this as a degenerate edge where the chamfer surfaces
intersect, producing non-manifold edges.

**The formula:**
```
total height H, chamfer c on top and bottom
flat face remaining = H - 2c
```
When `c = H/2`: flat face = 0 → degenerate.  
When `c = H/4`: flat face = H/2 → marginal but usually OK.  
**Target: flat face ≥ one layer height** (`m_lh`) so CGAL has real geometry to work with.

**Fix:** Compute chamfer to leave exactly one layer height of flat section:
```scad
// BAD — degenerate when height is small (EPS-thick flat face)
cuboid([w, d, bead_h + EPS], chamfer=bead_h/2, edges="ALL");
// flat face = (bead_h + EPS) - 2*(bead_h/2) = EPS = 0.1mm → degenerate

// GOOD — always leaves m_lh of flat face regardless of bead height
bead_chamf = (bead_h_ext - m_lh(data)) / 2;
cuboid([w, d, bead_h_ext], chamfer=bead_chamf, edges="ALL");
// flat face = bead_h_ext - 2*bead_chamf = m_lh = 0.28mm ✓
```

**When `bead_h_ext` varies by style** (External adds `m_chamf` to the height, Rabbet
keeps `bead_h + EPS`), the same `bead_chamf` formula still works — it adapts to whatever
height each style produces.

**Diagnostic:** if flat face < `EPS` (= 0.1mm), the geometry is almost certainly
non-manifold. If flat face < `m_lh` (= 0.28mm), it may be borderline depending on
how CGAL evaluates the face. Target ≥ `m_lh` for clean results.

---

### 11d. Cutter top coplanar with addition top inside `difference()`

In a `difference()`, if a **cutter** (child 2+) has a face exactly coplanar with the
**target solid's** (child 1) outer face, CGAL can produce non-manifold edges along the
shared boundary. This is distinct from Lesson 9 (which addresses the face being cut
itself) — here the cutter's terminating face lands on an addition's terminating face.

**The C-clip hinge example:**

```scad
// In local frame (parent translate at clip_z world):
// Connection block top face: local z = 0
// C-opening cutter top face: also local z = 0
//   → cutter terminates exactly at the solid's top face → non-manifold at boundary

translate([0, 0, -clip_outer_d/2])
    cuboid([clip_len+2, clip_gap, clip_outer_d], anchor=CENTER);
// cutter top = -clip_outer_d/2 + clip_outer_d/2 = 0  ← coplanar with block top ✗

// FIX: extend cutter by LINE_W so its top goes to local z = EPS
translate([0, 0, -clip_outer_d/2])
    cuboid([clip_len+2, clip_gap, clip_outer_d + LINE_W], anchor=CENTER);
// cutter top = -clip_outer_d/2 + (clip_outer_d + LINE_W)/2 = EPS ✓
```

**Why `LINE_W` and not `EPS`:** Adding `EPS` to the height moves the center by `EPS/2` and
the top by `EPS/2 + EPS/2 = EPS/2` — only `EPS/2 = 0.05mm` past the face. Adding `LINE_W`
to the height with a fixed center moves the top by `LINE_W/2 = EPS = 0.1mm`. Alternatively:
`translate z += EPS/2` + `height += EPS` also gives top at `EPS`. Either is fine; using
`clip_outer_d + LINE_W` on a fixed-center cuboid is cleaner to read.

**General rule:** For any `difference()` where the cutter has a face that might be
coplanar with the solid's face (not just the bottom/entry face), extend that cutter
face by EPS past the solid's face.

---

### 11e. Two additions sharing a face in `union()` — cross-addition coplanar faces

Not all coplanar non-manifold edges involve the chassis boundary. Two additions in the
same `union()` can have exactly matching faces in their overlap zone. CGAL sees this as
a zero-thickness internal boundary and produces non-manifold edges along it.

**The diamond tip / latch arm example:**

```scad
// Latch arm: width = lid_w - sw*4 → X faces at ±(lid_w - sw*4)/2
cuboid([lid_w - sw*4, 2.2, sl + clasp_depth + EPS], anchor=BOTTOM);

// Diamond tip hull — same X width:
hull() {
    cuboid([lid_w - sw*4, 0.1, noz*1.05], anchor=CENTER);  // ← same ±X faces
    ...
}
```

In the Z zone where latch arm and hull overlap, both solids have X faces at
`±(lid_w - sw*4)/2`. CGAL sees a coplanar internal boundary at both ±X planes.

**Fix:** Offset one solid's face by `EPS` so the other's face is interior to it:
```scad
// Make hull slightly wider — latch arm X faces are now interior to the hull volume
hull() {
    cuboid([lid_w - sw*4 + EPS, 0.1, noz*1.05], anchor=CENTER);
    cuboid([lid_w - sw*4 + EPS, noz*2, 0.1],    anchor=CENTER);
    cuboid([lid_w - sw*4 + EPS, 0.1, noz*1.05], anchor=CENTER);
}
```

**Which direction?** Make the outer shape (`hull`) slightly LARGER so the inner
shape (latch arm) is fully enclosed. If the inner shape were wider, the hull's faces
would be interior to the latch arm in the overlap zone — same fix, different choice
of which to offset.

**Detection:** If two additions in the same `union()` have any matching face
coordinate (even a non-chassis-boundary face), check whether they overlap in space.
If they overlap AND share a face coordinate, add `EPS` to separate them.

---

### 11f. Curved-surface tangency — cylinder face touching a flat face at a line

When a cylinder's curved surface is tangent to a flat face (touches at exactly one line), CGAL sees
a degenerate edge at that contact line. The tangent point is where the flat face and the cylinder
surface have exactly the same position — the union boundary is a mathematical line, not a face, which
is a degenerate condition.

**The Flip_Double spine pillar example:**

The spine pillar (a cuboid) bridges the two hinge axles. If the pillar Y dimension is exactly
`hinge_y*2 + hinge_d`, the pillar ±Y faces land exactly where the cylinder surface is tangent:

```
axle cylinder at Y = ±hinge_y, radius = hinge_d/2
tangent point  = ±(hinge_y + hinge_d/2) = ±(hinge_y*2+hinge_d)/2

pillar ±Y face = ±spine_w/2 = ±(hinge_y*2+hinge_d)/2   ← exactly tangent ✗
```

**Fix:** Widen the pillar so its ±Y faces extend slightly past the tangent points — the flat face
no longer touches the curved surface; it passes through it, producing a clean CGAL boolean:

```scad
// BAD — pillar ±Y face exactly tangent to axle cylinder surface ✗
spine_w = hinge_y*2 + hinge_d;

// GOOD — pillar ±Y face at ±(tangent_point + EPS), breaking tangency ✓
spine_w = hinge_y*2 + hinge_d + EPS*2;
```

**General rule:** Whenever a flat face would be geometrically tangent to a cylinder or sphere
surface (touching at a line or point), add EPS in that direction to move the flat face from tangent
to secant (the flat face cuts into the curved solid rather than just kissing it).

**Detection:** Compute the tangent coordinate analytically. If `flat_face_coord == center ± radius`
for any axis, the tangency condition holds → add EPS.

---

### 11g. Slicer "floating cantilever" — when it's real vs expected

The slicer warning "floating cantilever" (or "floating island") has two distinct causes:

**Cause A — Non-manifold repair artifact (geometry bug):** The slicer auto-repairs
non-manifold edges by capping zero-thickness gaps with paper-thin faces. These faces
are disconnected from the main model and appear as floating blobs in the slicer preview.
Root cause: a coplanar union face (see §11, §11c–§11e). Fix: apply the EPS rules and
eliminate the non-manifold edges. The warning disappears once the geometry is clean.

**Cause B — Geometric overhang at the slicer's 45° limit (expected):** Features
printed at exactly 45° overhangs trigger the slicer's cantilever detector but print
fine without supports. Examples in this codebase:

| Feature | Geometry | Verdict |
|---|---|---|
| Pull tab `BOTTOM+FRONT` chamfer | `chamfer=pull_tab_d/2` creates a 45° slope at the bed | Expected — self-supporting, no fix needed |
| Ball dimple sphere pole caps | Tiny (<0.1mm) disconnected zone at sphere tips | Sub-layer; benign in practice at ball_d=1.4mm |
| Flip lid C-clip arc opening | Faces downward (−Z) — correctly designed for face-down print | Expected — arc is self-supporting |

**How to tell them apart:**

1. Fix any non-manifold edges first (§11–§11k). Re-export the STL.
2. If the cantilever warning remains on the clean STL: it is Cause B (expected overhang).
   Accept it or redesign the overhang geometry.
3. If the warning disappears after fixing non-manifolds: it was Cause A.

**The pull tab 45° geometry is intentional.** The `chamfer=pull_tab_d/2` on the
`BOTTOM+FRONT` edge makes the tab's base slope at exactly 45° as it exits the bed
plane. This is the self-supporting FDM limit — the correct design. The slicer warning
is informational.

---

### 11h. Axle pin coplanar with inner wall — span dimension equals interior width

A cylinder spanning across the box interior with `h=w-sw*2` has half-length `(w-sw*2)/2 = w/2-sw`.
The box inner wall X face is at `±(w/2-sw)`. They are exactly equal — the chamfered end cap of the
axle pin lands exactly on the inner wall face → non-manifold.

**The math:**
```
axle pin half-length = (w - sw*2) / 2 = w/2 - sw
inner wall X face    = ±(w/2 - sw)
difference          = 0  ← coplanar ✗
```

With typical values (w=40, sw=2.4): both = ±17.6mm.

**Fix:** Add `LINE_W` to the span so both ends protrude `EPS` past the inner wall faces into the wall
material — the wall's solid body absorbs the tiny protrusion cleanly via `union()`:

```scad
// BAD — end cap coplanar with inner wall face
yrot(90) cyl(d=hinge_d, h=w - sw*2, chamfer=0.5, $fn=36);

// GOOD — ends at ±(w/2 − sw + EPS), inside wall material
yrot(90) cyl(d=hinge_d, h=w - sw*2 + LINE_W, chamfer=0.5, $fn=36);
```

**Detection rule:** Any cylinder or rod that spans the full interior width (or depth) with
`h = w - sw*2` (or `h = l - sw*2`) has coplanar ends. Always add `LINE_W` to these spans.

**Applies to:** Flip_Single axle pin (1 pin), Flip_Double axle pins (2 pins). Both use the
same formula. Each coplanar end cap produces multiple non-manifold edges at the circular
boundary — a single `LINE_W` fix on `h` resolves all of them.

---

### 11i. Two additions with equal span in a nested `union()` — connection block vs cylinder

When a cylinder and a rectangular block are `union()`-ed inside a `difference()`, and both have the
same axis-aligned span, their end faces are coplanar. CGAL produces non-manifold edges along the
boundary of the region where the two faces coincide.

**The C-clip foot example:**

```scad
union() {
    yrot(90) cyl(d=clip_outer_d, h=clip_len, ...);   // X extent: ±clip_len/2
    cuboid([clip_len, ...], anchor=CENTER);            // X extent: ±clip_len/2  ← coplanar ✗
}
```

Both have X end faces at exactly ±clip_len/2. In the overlap region in YZ, the faces coincide.
After the outer `difference()` subtracts the bore and C-opening, the remaining connection block
still has X faces at ±clip_len/2 coplanar with the cylinder's chamfered ends.

**Fix:** Extend the cylinder by `LINE_W` so it protrudes `EPS` past the block on each side, burying
the block X face inside the cylinder solid:

```scad
// BAD — block and cylinder both end at ±clip_len/2 → coplanar ✗
yrot(90) cyl(d=clip_outer_d, h=clip_len, chamfer=noz*3, $fn=36);
cuboid([clip_len, ...], anchor=CENTER);

// GOOD — cylinder ends at ±(clip_len/2+EPS); block face at ±clip_len/2 is interior ✓
yrot(90) cyl(d=clip_outer_d, h=clip_len+LINE_W, chamfer=noz*3, $fn=36);
cuboid([clip_len, ...], anchor=CENTER);
```

The block X face at ±clip_len/2 is now inside the cylinder solid → interior to the union → not on
the boundary → no coplanar issue.

**Direction matters — DO NOT shrink the block instead.** Shrinking to `clip_len - EPS` leaves an
EPS/2 = 0.05mm sliver between block end and cylinder end. CGAL treats near-zero-thickness geometry
as degenerate and produces MORE non-manifold edges, not fewer. Always extend the OUTER shape
(cylinder) so the inner shape (block) is fully enclosed.

**Which to extend?** Extend the outer/larger piece. Keep the structural piece (the block) at its
functional dimension.

**Detection rule:** Any two `union()` additions that use the same dimension expression for the same
axis — check their end faces. If both end at ±X, ±Y, or ±Z with the same arithmetic result, one
needs `− EPS` on that dimension.

### §11j — Addition translated to exact container wall face

When a `union()` addition (diamond latch, boss, pull tab) is translated so its root face lands
**exactly** on the container's outer wall face, CGAL sees two co-planar boundary faces at that
plane and produces non-manifold edges along the perimeter of the overlap.

```scad
// BAD — hull root (relative y=0) at absolute y = -l/2 = front wall outer face ✗
translate([0, -l/2, latch_z])
    hull() {
        translate([0, 0, 0.8]) cuboid([w-sw*4, 0.1, ...]);  // y=0 → absolute y=-l/2 ✗
        translate([0, -0.8, 0]) cuboid([...]);
    }

// GOOD — root face at -l/2+EPS = just inside wall material ✓
translate([0, -l/2 + EPS, latch_z])
    hull() { ... }  // same geometry, +EPS offset so root is interior, not coplanar
```

For bilateral features (Flip_Double, ±Y symmetric): `translate([0, sy * (l/2 - EPS), latch_z])`.

**Also applies to the floor**: any pillar or boss with `anchor=BOTTOM` placed at Z=sf (floor top
face) is coplanar with the floor top. Fix: translate to `sf - EPS`, increase height by `EPS` to
keep the top at the same position.

```scad
// BAD — pillar bottom at sf = floor top face ✗
translate([x, y, sf]) cuboid([w, d, h], anchor=BOTTOM);

// GOOD — pillar sunk EPS into floor, height += EPS so top stays at axle crown ✓
translate([x, y, sf - EPS]) cuboid([w, d, h + EPS], anchor=BOTTOM);
```

**Detection rule:** Any `translate([..., sf])` with `anchor=BOTTOM` placing a feature on the
floor top — add `- EPS` to the Z translation and `+ EPS` to the height.

---

### §11k — Addition root face inside body chamfer zone

`apply_master_bounds` (and any `cuboid` with `chamfer=`) removes material in a triangular zone near
each edge. When a second `union()` solid has any face — including its **side faces** — passing
through that chamfer zone, three planes (body face, chamfer face, addition side face) converge near
the same line — CGAL produces non-manifold edges along that intersection.

**Example:** Flip_Single lid latch arm. The arm's ±X side faces are at `±(lid_w-sw*4)/2`. The lid
body has a front-bottom chamfer zone from Z=0 up to `chamf = max(noz, m_chamf)` near Y=-lid_l/2.
Any arm material in this zone means the arm ±X faces pass through the chamfer face plane → NM edges.

**Wrong first attempt — extend back face past chamfer zone:**
```scad
// WRONG — burying back face deeper extends arm into chamfer zone, making things WORSE ✗
arm_bury = max(noz, m_chamf(data)) + noz;
translate([0, -lid_l/2 + arm_bury, -EPS])
    cuboid([lid_w-sw*4, 2.2 + arm_bury, sl+clasp_depth+EPS], anchor=BACK+BOTTOM);
// arm now spans the ENTIRE chamfer zone height at ±X, creating a longer NM intersection line
```

This backfired because anchoring to `BACK+BOTTOM` and extending the arm deeper through the chamfer
zone increased the intersection length of arm ±X faces with the chamfer face plane.

**Correct fix — raise arm BOTTOM above the chamfer zone entirely:**
```scad
// GOOD — arm bottom starts above chamfer zone; no arm material in Z=0 to chamf zone ✓
chamf = max(noz, m_chamf(data));
translate([0, -lid_l/2 - 1.1 + EPS, chamf + EPS])
    cuboid([lid_w-sw*4, 2.2, sl + clasp_depth - chamf - EPS], anchor=BOTTOM);
// arm Z range: chamf+EPS to sl+clasp_depth  ← entirely above chamfer zone
// arm Y range: -lid_l/2-2.2+EPS to -lid_l/2+EPS  ← unchanged (geometry preserved)
// arm height: sl+clasp_depth-chamf-EPS  ← reduced by chamf to keep top at sl+clasp_depth
```

**Key insight:** The chamfer zone occupies Z=0 to `chamf` near the body's bottom corners. An arm
side face at ±X that passes through this zone at ANY Z value creates an intersection. The fix is not
about the back/front face position — it is about keeping the arm's **Z range entirely above the
chamfer zone**.

**Detection rule:** For any `union()` solid adjacent to a chamfered body corner, ask: do the solid's
±X (or ±Y) side faces pass through the Z range `[0, chamf]` near the corresponding body edge? If
yes, raise the solid's bottom to `chamf + EPS` and reduce its height by `chamf + EPS` to keep the
top at the same position.

**The wrong-direction failure mode to avoid:** burying a feature's ROOT face deeper into the body
moves MORE of the feature into the chamfer zone (more material at low Z), not less. The arm root
and the arm side faces are orthogonal — fixing root position does not fix side-face intersection.

---

## 12. How to hunt non-manifold edges — the diagnostic playbook

This is the workflow used to find and fix all non-manifold edges in this codebase. Knowing the
method is as important as knowing the fixes — the same patterns recur whenever new geometry is added.

### Step 1 — Get a count baseline with `check_manifold.py`

```
python check_manifold.py STL/
```

This counts edges shared by >2 faces in every STL/3mf found. Zero NM edges = clean. Non-zero = work
to do. Run this after every export cycle to confirm fixes actually reduced the count.

```
python check_manifold.py "STL/Flip Lids.STL"   # single file
python check_manifold.py STL/                  # entire directory
```

The script also reports boundary edges (count=1). A healthy closed mesh has zero boundary edges too.
Boundary edges indicate holes in the mesh — a different (usually worse) problem.

### Step 2 — Locate the feature by clustering Z coordinates

NM edges cluster at specific Z heights that correspond to geometry features. Extract where they are:

```python
import pymeshlab, numpy as np
from collections import defaultdict

ms = pymeshlab.MeshSet()
ms.load_new_mesh("STL/Flip Lids.STL")
faces = ms.current_mesh().face_matrix()
verts = ms.current_mesh().vertex_matrix()

edge_verts = defaultdict(list)
for f in faces:
    for a, b in ((f[0],f[1]), (f[1],f[2]), (f[0],f[2])):
        edge_verts[(min(a,b), max(a,b))].append(f)

nm_zs = []
for (a, b), flist in edge_verts.items():
    if len(flist) > 2:
        nm_zs.append((verts[a][2] + verts[b][2]) / 2)

print(sorted(set(round(z, 2) for z in nm_zs)))
```

**What the Z values tell you:**

| Z cluster | What it is |
|---|---|
| Z ≈ 0 | Lid or box floor — features at the print bed level |
| Z ≈ sf (floor height) | Box interior floor — pillar bottoms, grid bases |
| Z ≈ sl (lid height) | Lid top face — additions at lid surface |
| Z ≈ bh (box height) | Box top — pillar tops, hinge crown |
| Z ≈ sf = sl | **Platter artifact** — floor and lid heights are equal (see §12b) |

### Step 3 — Visualize with MeshLab (optional but fast for new bugs)

1. Open STL in MeshLab
2. `Filters → Selection → Select non Manifold Edges` — red faces appear adjacent to problem edges
3. `Render → Wireframe` mode — yellow edges show the NM edges
4. Zoom in on the red patches to understand the geometric relationship

**Red patch shapes and what they mean:**

| Shape | Likely cause |
|---|---|
| Two symmetrical red stripes at ±X on a lid face | Side face of addition passing through chamfer zone (§11k) |
| Small red corners at bottom of a pillar or boss | Pillar bottom coplanar with floor (§11j) |
| Red stripe along a full edge shared by two features | Two additions with coplanar face (§11e) |
| Red at both ends of a cylinder | Cylinder span equals interior width (§11g) |
| Diagonal red stripes on a chamfered corner | Addition protruding past a wall (§11b wrong direction) |
| Red crown on C-clip | Cutter top coplanar with block top (§11d) |
| Entire top surface pink / diffuse | >2 faces at every edge — platter artifact (§12b) |

### Step 4 — Map the Z cluster to a file and feature

From the Z height and visual shape, identify which feature in which file produced the NM edges:

| Z range | File | Feature to audit |
|---|---|---|
| Z ≈ 0–1mm on a lid | `RenderLid.scad` | Pull tab, latch arm, snap bead, ball sphere |
| Z ≈ sf on a box | `RenderBox.scad` | Hinge pillars, spine pillars, diamond latch hull |
| Z ≈ bh on a box | `RenderBox.scad` | Pillar top, axle crown |
| Any Z on a cylinder | Check axle pins, C-clip cylinder, jar neck |

### Step 5 — Apply the §11 fix

Identify the pattern from the confirmed-instances table in §11, apply the EPS fix, re-export, re-run
`check_manifold.py`. Confirm the count drops. If it doesn't: the math predicted a coplanar face but
the actual geometry is different — re-read the translate/dimension expressions carefully.

**Most common mistake:** applying EPS in the wrong direction (§11b). Always verify: does the fix
move the face **into** the chassis material, or **past** it?

### Step 6 — Distinguish real bugs from platter artifacts

Not every NM edge in a bulk export is a printability problem. See §12b.

---

### §12b — Platter artifact: benign NM edges when sf = sl

When multiple parts are unioned into a display platter, and two parts have faces at the same Z
height, those faces are coplanar in the platter mesh → NM edges. This happens consistently when:

- Box floor height `sf` and lid height `sl` are both snapped to layer boundaries
- Both snap to the same multiple of layer height (e.g., 7 × 0.28mm = 1.96mm)
- Platter unions box (top face at `bh`) and lid (top face at `sl = 1.96mm`)
  but also box floor top at `sf = 1.96mm` coincides with lid top at `sl = 1.96mm`

**How to confirm it's a platter artifact:**

1. Export a single part (just the box, or just the lid) as a separate STL
2. Run `check_manifold.py` on that single-part file
3. If it reports 0 NM edges → the individual geometry is clean; the NM edges were platter artifacts

**Is it a printability problem?**

No — with one exception. NM edges **at Z=0** (the print bed level) can confuse slicers into
treating the first layer as disconnected faces, preventing "elephant's foot" compensation from
working. NM edges at Z=sf or Z=sl (above the bed) are cosmetic — slicers generate valid toolpaths
through them.

**When to fix platter artifacts:**

Only if Z=0 NM edges appear in the platter. If all NM edges are at Z>0 (Z=sf, Z=sl, Z=bh), leave
them — fixing them would require adding sub-EPS geometry to the platter assembly code, which adds
complexity for zero print benefit.

---

### §12c — Confirming individual parts are clean

The canonical check before pushing:

```
# Export one representative of each primitive type as a single-part STL
# Then run:
python check_manifold.py STL/
```

All NM edge counts should be 0. If a platter file shows N NM edges but the constituent single-part
files show 0 each → the codebase is clean; the platter NM edges are artifacts only.

---

## 13. The complete non-manifold picture — four root causes and how this codebase handles them

OpenSCAD's non-manifold problem has exactly four root causes. This section is the executive
summary — the full details are in §9–§12k. Read this first; drill into the numbered sections
when you need the specific fix.

---

### 13a. Zero-thickness coincidence (the "overlap trick")

**Root cause:** A `difference()` cutter's face lands exactly flush with the face it is
supposed to pierce. The engine cannot determine which side of the boundary each vertex
belongs to → Z-fighting in preview, non-manifold edge on export.

**The textbook example:**
```scad
// BAD — cutter top at Z=10, solid top at Z=10 → zero-thickness coincidence
difference() {
    cube([50, 50, 10]);
    translate([5, 5, 2]) cube([40, 40, 8]);  // top: 2+8 = 10 = solid top ✗
}
```

**This codebase's fix:** Two distinct epsilon values with different semantics:

| Constant | Value | Meaning | Parametric? |
|---|---|---|---|
| `EPS` | 0.01mm | Single-sided cutter overlap. 10 microns — below any FDM resolution, dimensionally invisible. The Goldilocks zone for CGAL: large enough to register as a distinct surface, small enough that no physical dimension shifts. | Customizer: `bool_overlap_eps` |
| `LINE_W` | `Nozzle_Diameter` | Double-sided cutter overlap = one full nozzle line width (0.4mm at default). Scales with printer settings; at 0.6mm nozzle = 0.6mm. | `MasterBuilder.scad`: `LINE_W = Nozzle_Diameter` |

Why 0.01mm and not 0.1mm: 0.1mm is 1/4 of the nozzle diameter — borderline measurable.
EPS appears on interior shared faces and cutter extensions, never on visible outer surfaces,
but keeping it at 10 microns ensures no dimension is altered by even a fraction of a layer.
Why not 0.001mm or smaller: CGAL uses exact arithmetic for boolean operations, but the mesh
is generated using floating-point `sin()`/`cos()` for arc vertices. Below ~0.005mm the
vertex-position error from trig rounding can match the EPS value — the separation disappears.
0.01mm is safely above that floor. Verified: nm_hunt.py passes identically at 0.01mm.

Why `LINE_W = Nozzle_Diameter` and not `EPS * 2`: LINE_W is used where a cutter must pierce
BOTH faces symmetrically (axle pin ends, slot cutters, hub hollow cores). Tying it to one
nozzle line width gives a semantically meaningful unit — the minimum printable increment —
and scales correctly as nozzle size changes. `LINE_W/2` per face is the per-face overlap.

Defined in `MasterEngine.scad`; overridden by the Customizer assignments after all includes.

See §9 for the full EPS reference.

---

### 13b. Coplanar face in union() (the "butterfly edge")

**Root cause:** A `union()` addition's face lands exactly on the chassis boundary, or on
another addition's face. CGAL produces edges shared by 4 faces instead of 2 → non-manifold.
The slicer auto-repairs by capping the zero-thickness gap with a paper-thin disconnected face,
which prints as a floating blob.

**Two variants:**
- Addition face coincides with **chassis wall** (§11, §11b, §11i, §11j)
- Addition face coincides with **another addition's face** in the same `union()` (§11e, §11h)

**This codebase's fix:** Shrink additions inward by EPS so their face is inside the chassis
material, not flush with the boundary. "Shrink inward, never grow outward" — §11b.

Every confirmed instance with its exact fix is in the table in §11.

---

### 13c. Curved-surface tangency (the "kiss" problem)

**Root cause:** A cylinder or sphere surface is geometrically tangent to a flat face — they
touch at exactly one line or point. CGAL sees a degenerate edge at that contact. Not a
floating-point issue; it is exact-arithmetic tangency. Occurs in any CSG system, not just
OpenSCAD.

**Example:** Flip_Double spine pillar width = `hinge_y*2 + hinge_d` places the pillar ±Y
faces exactly tangent to the axle cylinders.

**This codebase's fix:** Add EPS to make the flat face secant (cuts through) instead of
tangent (just kisses). `spine_w = hinge_y*2 + hinge_d + EPS*2`. See §11f.

**Detection:** Compute `flat_face_coord == center ± radius` algebraically. If equal → tangency
→ add EPS.

---

### 13d. Chamfer zone intersection (addition root inside body chamfer zone)

**Root cause:** `apply_master_bounds` removes material in a triangular zone near each body
edge. If a `union()` addition's side faces pass through that zone at any Z, three planes
converge (body face, chamfer face, addition side face) → non-manifold corners.

**Critical insight:** The failure is caused by the **side faces** of the addition passing
through the chamfer zone, not the root face position. Burying the root face deeper into the
body moves MORE side face into the chamfer zone — making things worse, not better.

**This codebase's fix:** Raise the addition's bottom to `chamf + EPS` so zero material exists
in the Z=0 to chamf zone. Reduce height by the same amount to keep the top unchanged.
See §11k.

---

### 13e. This codebase uses CSG only — rules 2 and 3 don't apply

FrankenTray ribs and hubs are `cuboid()` and `cyl()` from BOSL2, clipped with
`apply_master_bounds` / `intersection()`. There are **no `polyhedron()` calls** anywhere.

Consequences:
- **Vertex winding** is handled automatically by BOSL2 and CGAL. No manual CCW/CW tracking needed.
- **Shared vertex references** are guaranteed by CGAL's exact arithmetic. No floating-point
  drift between adjacent primitives.
- **Boolean union** is the architecture — shapes are never merged by concatenating triangle
  lists. `union()`, `difference()`, `intersection()` are the only merge operations.

If `polyhedron()` is ever added (e.g., for organic shapes BOSL2 can't express), the separate
mesh generation rules apply — see the mesh-generation-rules memory entry.

---

### 13f. The Manifold render engine — faster iteration, same export rules

OpenSCAD 2023+ includes a new **Manifold** rendering backend that replaces CGAL for
interactive F6 renders. Enable it at `Edit → Preferences → Features → manifold`.

**What it improves:** Dramatically faster F6 render times (seconds instead of minutes on
complex geometry). More tolerant of near-coincident faces during interactive preview.

**What it does NOT change:** The exported STL is still a triangle mesh that slicers process
independently. Coplanar faces from `union()` coincidences still appear in the export and
still trigger slicer warnings. The EPS rules remain necessary for clean STL output.

**Rule of thumb:** Use Manifold for interactive development. Run `nm_hunt.py` on the exported
STL to confirm the mesh is clean regardless of which engine produced it.

---

### 13g. The automated verification pipeline

`nm_hunt.py` is the canonical pre-push check. It exports every lid type and box variant via
OpenSCAD CLI, checks each STL with pymeshlab, and distinguishes real bugs from platter artifacts.

```
python nm_hunt.py
```

**Platter artifacts are detected automatically.** An NM edge that is 4-face-sharing AND at
Z > 0 is classified as a benign platter artifact (`sf = sl` layer-snap coincidence). Any
3-face-sharing NM edge, or any edge at Z ≤ 0.05mm, is flagged as a real bug.

**Verified clean (2026-06-09):** All 7 standalone lid types (Slip, Snap×2, Glide×2,
Flip_Single, Screw) exported at 0 NM edges. The 6 box platters each show 4-face-sharing NM
edges at Z=1.96mm only — confirmed benign.

Run `nm_hunt.py` after any geometry change before committing.
